aokblast/ThunderChargeXPro/RC_Charger_MainBoard/production/RC_Charger_MainBoard_2024-02-06_21-02-52/bom.csv

Designator | Footprint | Quantity | Value | LCSC Part #
C1, C2 | CP_EIA-3528-21_Kemet-B | 2 | 10u
C10, C7, C8, C9 | CP_Elec_6.3x7.7 | 4 | 68u
C11, C12, C13, C23, C270, C273, C3 | 0603 | 7 | 0.1u
C14, C26 | CP_Elec_10x10 | 2 | 560u
C27, C4, C44, C45, C46 | 1206 | 5 | 1u
C28, C29, C30, C31 | CP_Elec_6.3x5.4 | 4 | 22u
C47, C49, C51, C53 | 0805 | 4 | 0.47u
C48, C50, C52, C54 | 0805 | 4 | 0.68u
C5 | CP_Elec_4x5.7 | 1 | 10u
C6 | 0603 | 1 | 2.2n
D1 | D_SMA | 1 | CDBA360-HF
D2, D3 | D_SMA | 2 | SS54F
H1, H2, H3, H4 | MountingHole_4.3mm_M4_DIN965_Pad_TopBottom | 4 | M4
H5, H6 | MountingHole_8.4mm_M8_Pad_Via | 2 | M8
J1, J9 | PinHeader_2x03_P2.54mm_Vertical | 2 | Conn_02x03_Odd_Even
J3 | JST_XH_B2B-XH-A_1x02_P2.50mm_Vertical | 1 | SPK1
J4 | JST_XH_B2B-XH-A_1x02_P2.50mm_Vertical | 1 | SPK2
L1 | L_Taiyo-Yuden_NR-80xx_HandSoldering | 1 | 100u
L2, L3, L4, L5 | L_Taiyo-Yuden_NR-50xx_HandSoldering | 4 | 10u
L6, L7 | L_Bourns_SRR1260 | 2 | 15u
R1 | 0603 | 1 | 68k
R10, R17, R2 | 0603 | 3 | 10k
R11 | 0603 | 1 | 3.24k
R18 | 0603 | 1 | 5.9k
R4 | 0603 | 1 | 53.6k
R5 | 0603 | 1 | 12.1k
R6 | 0603 | 1 | 54.9k
R7 | 0603 | 1 | 2.43k
R8 | 0603 | 1 | 52.3k
R9 | 0603 | 1 | 73.2k
U1 | MODULE_NUCLEO-H745ZI-Q | 1 | NUCLEO-H745ZI-Q
U13 | VQFN-32-1EP_5x5mm_P0.5mm_EP3.1x3.1mm | 1 | TAS5825MRHB
U2 | 4-inch SPI screen | 1 | ~
U3 | TO-252-2 | 1 | L7805
U4 | SOIC-8_3.9x4.9mm_P1.27mm | 1 | LM5001MA
U5, U6 | Texas_R-PDSO-G8_EP2.95x4.9mm_Mask2.4x3.1mm_ThermalVias | 2 | TPS5430DDA
