aokblast/ThunderChargeXPro/FullBOM.xlsx

Sheet: ChargerPowerBoard
Designator | Value | Footprint | Quantity | quantity |  |  |  |  | 4619.67
C10,C33,C42,C55 | 100u | CP_Elec_6.3x7.7 |  | 4 | 14 | VZL101M1VTR-0607 (https://www.mouser.tw/ProductDetail/Lelon/VZL101M1VTR-0607) | 7.18 | 100.52
C11,C12,C13,C14,C30,C31,C32,C56,C57,C58,C59,C75,C76,C77 | 10u | 1206 |  | 14 | 49 | CL31A106MBHNNNE (https://www.mouser.tw/ProductDetail/Samsung-Electro-Mechanics/CL31A106MBHNNNE?qs=vLWxofP3U2ynwxdpGjlUyw%3D%3D) | 4.28 | 209.72
C17,C21,C23,C25,C27,C28,C62,C66,C68,C70,C72,C73 | 0.1u | 0603 |  | 12 | 42 | C0603C104M5RACAUTO (https://www.mouser.tw/ProductDetail/KEMET/C0603C104M5RACAUTO?qs=LnFVCKo%2FxLlaItaNxnozvw%3D%3D) | 1.27 | 53.34
C19,C64 | 560p | 0603 |  | 2 | 7 | CL10C561JB8NFNC (https://www.mouser.tw/ProductDetail/Samsung-Electro-Mechanics/CL10C561JB8NFNC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) | 0.923 | 6.461
C22,C67 | 68n | 0603 |  | 2 | 7 | CGA3E2X7R1H683M080AA (https://www.mouser.tw/ProductDetail/TDK/CGA3E2X7R1H683M080AA?qs=xLDY6iXSiQbQRXw5HcsOLg%3D%3D) | 1.71 | 11.97
C35,C36,C43,C44 | 22u | CP_Elec_6.3x5.4 |  | 4 | 14 | EEE-1VA220SP (https://www.mouser.tw/ProductDetail/Panasonic/EEE-1VA220SP) | 7.59 | 106.26
C38,C40,C92,C94 | 26p16V | 0603 |  | 4 | 14 | AC0603JRNPO9BN270 (https://www.mouser.tw/ProductDetail/YAGEO/AC0603JRNPO9BN270?qs=tS%2FAHvPQ%2F55GxSiGDraFxQ%3D%3D) | 1.4 | 19.6
D5 | SM4001 | D_MELF |  | 1 | 4 | SM4001 (https://www.mouser.tw/ProductDetail/Diotec-Semiconductor/SM4001?qs=OlC7AqGiEDlqPXaWDPfaLg%3D%3D) | 5.64 | 22.56
D6 | SM4001 | D_MELF |  | 1 | 4 | SM4001 (https://www.mouser.tw/ProductDetail/Diotec-Semiconductor/SM4001?qs=OlC7AqGiEDlqPXaWDPfaLg%3D%3D) |  | 0
K5,K6 | Relay_SPST-NO | T9GV5L145 |  | 2 | 7 | T9GV5L14-5 (https://www.mouser.tw/ProductDetail/TE-Connectivity-PB/T9GV5L14-5) | 108.42 | 758.94
L1,L6 | 4.7u | L_Bourns_SRP1770TA_16.9x16.9mm |  | 2 | 7 | SRP1770TA-4R7M (https://www.mouser.tw/ProductDetail/Bourns/SRP1770TA-4R7M?qs=P%2FbxraXw5h0TW8hufbRYNQ%3D%3D) | 94.06 | 658.42
Q10,Q11,Q12,Q13,Q14,Q7,Q8,Q9 | IRFH5210 | PQFN-8-EP_6x5mm_P1.27mm_Generic |  | 8 | 28 | IRFH7545TRPBF (https://www.mouser.tw/ProductDetail/Infineon-Technologies/IRFH7545TRPBF?qs=NBFAU1oqP4Xy0KalJOxHdQ%3D%3D) | 21.34 | 597.52
Q21,Q22 | AO3400A | SOT-23 |  | 2 | 7 | IRLML6344TRPBF (https://www.mouser.tw/ProductDetail/Infineon-Technologies/IRLML6344TRPBF?qs=9%252BKlkBgLFf2w4qS48UOXVw%3D%3D) | 12.76 | 89.32
R1,R2,R3,R4,R5,R6,R77,R78,R79,R80,R81,R82 | 50 | 2512 |  | 12 | 42 | CRCW251249R9FKEGHP (https://www.mouser.tw/ProductDetail/Vishay-Dale/CRCW251249R9FKEGHP?qs=k2%2FDWSARqgFnooSUq8QfKQ%3D%3D) | 14.78 | 620.76
R107,R108,R109,R110,R111,R112,R113,R114,R115,R116,R117,R118,R31,R32,R33,R34,R35,R36,R37,R38,R39,R40,R41,R42 | 7.87k | 0603 |  | 24 | 84 | CRCW06037K87FKEA (https://www.mouser.tw/ProductDetail/Vishay-Dale/CRCW06037K87FKEA?qs=IojMgTCMkEdTY99SGkX1pA%3D%3D) | 0.342 | 28.728
R119,R120,R58,R59 | 68 | 0603 |  | 4 | 14 | CRCW060368R0FKEAHP (https://www.mouser.tw/ProductDetail/Vishay-Dale/CRCW060368R0FKEAHP?qs=YmE2lSBYOPlEK%2FcM9tkokA%3D%3D) | 1.74 | 24.36
R245,R246 | 1.5M | 0603 |  | 2 | 7 | CRCW06031M50FKEA (https://www.mouser.tw/ProductDetail/Vishay-Dale/CRCW06031M50FKEA?qs=ZrSeLeYd2mLBVxYQ1%252B0cuQ%3D%3D) | 0.581 | 4.067
R249,R252 | 9.53k | 0603 |  | 2 | 7 | CRCW06039K53FKEA (https://www.mouser.tw/ProductDetail/Vishay-Dale/CRCW06039K53FKEA?qs=NvrC5vRk3q5mn1EuZvzW6A%3D%3D) | 0.581 | 4.067
R47,R66 | 42.2k | 0603 |  | 2 | 7 | CRCW060342K2FKEA (https://www.mouser.tw/ProductDetail/Vishay-Dale/CRCW060342K2FKEA?qs=v0cjL%2FPx3nyx0V5tfB02DQ%3D%3D) | 0.65 | 4.55
R50,R69 | 2.61k | 0603 |  | 2 | 7 | CRCW06032K61FKEA (https://www.mouser.tw/ProductDetail/Vishay-Dale/CRCW06032K61FKEA?qs=rWmqDOB7Xyh0TeaTOrunVg%3D%3D) | 0.581 | 4.067
R53,R72 | 3m | 2818 |  | 2 | 7 | WSHM28183L000FEB (https://www.mouser.tw/ProductDetail/Vishay-Dale/WSHM28183L000FEB?qs=OiptqVrkjbpQDIrtklFs6Q%3D%3D) | 43.1 | 301.7
R55,R74 | 3m | R_Shunt_Vishay_WSK2512_6332Metric_T2.21mm |  | 2 | 7 | MSMA2512R0030FEN (https://www.mouser.tw/ProductDetail/Bussmann-Eaton/MSMA2512R0030FEN?qs=By6Nw2ByBD06wTr8XIiA3Q%3D%3D) | 9 | 63
R57,R76 | 4m | R_Shunt_Vishay_WSK2512_6332Metric_T2.21mm |  | 2 | 7 | MSMA2512R0040FEN (https://www.mouser.tw/ProductDetail/Bussmann-Eaton/MSMA2512R0040FEN?qs=By6Nw2ByBD3A3gmSEIRZGQ%3D%3D) | 9 | 63
U10,U16 | MP2984 | QFN-32-1EP_4x4mm_P0.4mm_EP2.65x2.65mm |  | 2 | 7 |  |  | 0
U11,U17 | INA180A1 | SOT-23-5 |  | 2 | 7 | INA180A1IDBVR (https://www.mouser.tw/ProductDetail/Texas-Instruments/INA180A1IDBVR?qs=5aG0NVq1C4wnkaOukGk95A%3D%3D) | 10.88 | 76.16
U59,U62 | INA240A1D | SOIC-8_3.9x4.9mm_P1.27mm |  | 2 | 7 | INA240A1DR (https://www.mouser.tw/ProductDetail/Texas-Instruments/INA240A1DR?qs=AQlKX63v8Rv7XB07RTzuHA%3D%3D) | 94.06 | 658.42
Y1,Y2 | 8M | Crystal_SMD_Abracon_ABM3B-4Pin_5.0x3.2mm |  | 2 | 7 | ABM3B-8.000MHZ-B2-T (https://www.mouser.tw/ProductDetail/ABRACON/ABM3B-8.000MHZ-B2-T?qs=NE97hfUNX0Ef9OqIOqO2cA%3D%3D) | 18.88 | 132.16

Sheet: ChargerMainBoard
Designator | Value | Footprint | Quantity | quantity |  |  |  |  | 1544.2
R7 | 2.43k | 0603 |  | 1 | 10 | CRCW06032K43FKEA (https://www.mouser.tw/ProductDetail/Vishay-Dale/CRCW06032K43FKEA?qs=eDxIiLd4fLRD3G8bVTELcA%3D%3D) | 0.65 | 6.5
R18 | 5.9k | 0603 |  | 1 | 10 | CRCW06035K90FKEA (https://www.mouser.tw/ProductDetail/Vishay-Dale/CRCW06035K90FKEA?qs=2kV0shNyW71rKkh24eBQEg%3D%3D) | 0.581 | 5.81
R5 | 12.1k | 0603 |  | 1 | 10 | CRCW060312K1FKEA (https://www.mouser.tw/ProductDetail/Vishay-Dale/CRCW060312K1FKEA?qs=BcvNGmdp0KVGHQVkR%252BFsVA%3D%3D) | 0.65 | 6.5
R8 | 52.3k | 0603 |  | 1 | 10 | CRCW060352K3FKEA (https://www.mouser.tw/ProductDetail/Vishay-Dale/CRCW060352K3FKEA?qs=SnLvHVux46osufKy5hEuZA%3D%3D) | 0.581 | 5.81
R9 | 73.2k | 0603 |  | 1 | 10 | CRCW060373K2FKEA (https://www.mouser.tw/ProductDetail/Vishay-Dale/CRCW060373K2FKEA?qs=wtKLRx7HFiWbNo88VwpoiQ%3D%3D) | 0.65 | 6.5
R11 | 3.24k | 0603 |  | 1 | 10 | CRCW06033K24FKEAC (https://www.mouser.tw/ProductDetail/Vishay-Dale/CRCW06033K24FKEAC?qs=E3Y5ESvWgWMGhBnGc19ywA%3D%3D) | 0.616 | 6.16
C5 | 10u | CAP-SMD_BD5.0-L5.3-W5.3-LS6.3-FD |  | 1 | 3 | EDH106M050A9DAA (https://www.mouser.tw/ProductDetail/KEMET/EDH106M050A9DAA) | 7.18 | 21.54
U4 | LM5001MA | SOIC-8_3.9x4.9mm_P1.27mm |  | 1 | 3 | LM5001MAX/NOPB (https://www.mouser.tw/ProductDetail/Texas-Instruments/LM5001MAX-NOPB?qs=QbsRYf82W3FL7Egz0HJkAQ%3D%3D) | 150.49 | 451.47
C48,C50,C52,C54 | 0.68u | 0805 |  | 4 | 10 | C0805C684K5REC7210 (https://www.mouser.tw/ProductDetail/KEMET/C0805C684K5REC7210) | 5.68 | 56.8
U13 | TAS5825MRHB | VQFN-32-1EP_5x5mm_P0.5mm_EP3.1x3.1mm |  | 1 | 3 | TAS5825MRHBR (https://www.mouser.tw/ProductDetail/Texas-Instruments/TAS5825MRHBR?qs=f9yNj16SXrKGX4MqJgnnYg%3D%3D) | 124.5 | 373.5
R4 | 53.6k | 0603 |  | 1 | 10 | CRCW060353K6FKEA (https://www.mouser.tw/ProductDetail/Vishay-Dale/CRCW060353K6FKEA?qs=t%2Fk8jExiEqtUVENO6f39Cw%3D%3D) | 0.581 | 5.81
R6 | 54.9k | 0603 |  | 1 | 10 | CRCW060354K9FKEA (https://www.mouser.tw/ProductDetail/Vishay-Dale/CRCW060354K9FKEA?qs=b7E%2F5v%252Bp8lqNIpTCMX%252BLUg%3D%3D) | 0.581 | 5.81
L6,L7 | 15u | L_Bourns_SRR1260 |  | 2 | 5 | SRR1260-150M (https://www.mouser.tw/ProductDetail/Bourns/SRR1260-150M?qs=y9m3SKnhpLPF5BoYDkDwgQ%3D%3D) | 25.31 | 126.55
L1 | 100u | L_Taiyo-Yuden_NR-80xx_HandSoldering |  | 1 | 3 | NR8040T101M (https://www.mouser.tw/ProductDetail/TAIYO-YUDEN/NR8040T101M?qs=PzICbMaShUf5KnjQbcM1ow%3D%3D) | 15.73 | 47.19
C10,C7,C8,C9 | 68u | CP_Elec_6.3x7.7 |  | 4 | 10 | EEV686M035A9HAA (https://www.mouser.tw/ProductDetail/KEMET/EEV686M035A9HAA) | 10.23 | 102.3
L2,L3,L4,L5 | 10u | L_Taiyo-Yuden_NR-50xx_HandSoldering |  | 4 | 10 | NR5040T100M (https://www.mouser.tw/ProductDetail/TAIYO-YUDEN/NR5040T100M?qs=PzICbMaShUcSxn8FHypdZA%3D%3D) | 7.76 | 77.6
C28,C29,C30,C31 | 22u | CP_Elec_6.3x5.4 |  | 4 | 10 | EEE-1VA220SP (https://www.mouser.tw/ProductDetail/Panasonic/EEE-1VA220SP) | 7.59 | 75.9
C14,C26 | 560u | CP_Elec_10x10 |  | 2 | 5 | EEE-FN1V561UP (https://www.mouser.tw/ProductDetail/Panasonic/EEE-FN1V561UP) | 32.49 | 162.45

Sheet: Order
 |  |  |  |  |  | 21261.671 |  |  |  |  | 9297.477
C0603C104J5RAC7411 (https://www.mouser.tw/ProductDetail/KEMET/C0603C104J5RAC7411?qs=sGAEpiMZZMvsSlwiRhF8qnxGm16OHeZjwoFLW7GiWz0%3D) | 127 | C2220C226M5R2CT500 (https://www.mouser.tw/ProductDetail/KEMET/C2220C226M5R2CT500?qs=cRF2oMUWtTcXdS78BxhVuQ%3D%3D) | 30 | 140.57 | 4217.1 |  | LM5001MAX-NOPB | 3 | 150.49 | 451.47
AEK1010101M050R (https://www.mouser.tw/ProductDetail/KYOCERA-AVX/AEK1010101M050R?qs=MyNHzdoqoQIQJGuoaqHnWA%3D%3D) | 19 | STM32F103CBT6TR | 10 | 178.54 | 1785.4 |  | SRP1770TA-4R7M | 6 | 142.97 | 857.82
C1210C106K6PACTU (https://www.mouser.tw/ProductDetail/KEMET/C1210C106K6PACTU?qs=sGAEpiMZZMvsSlwiRhF8qnaoi2Fm8R546YxnrmKumDM%3D) | 64 | IRFH5210TRPBF | 37 | 41.73 | 1544.01 |  | TAS5825MRHBR | 3 | 124.5 | 373.5
C0805X225K5RACAUTO (https://www.mouser.tw/ProductDetail/KEMET/C0805X225K5RACAUTO?qs=HBWAp0VN4Ri3sxmR2yBS2w%3D%3D) | 19 | WSLP27264L000FEA | 19 | 61.57 | 1169.83 |  | T9GV5L14-5 | 6 | 114.92 | 689.52
C0603C104J5RAC7411 (https://www.mouser.tw/ProductDetail/KEMET/C0603C104J5RAC7411?qs=sGAEpiMZZMvsSlwiRhF8qnxGm16OHeZjwoFLW7GiWz0%3D) | 55 | TPS54560BDDA | 6 | 184.01 | 1104.06 |  | INA240A1DR | 6 | 110.48 | 662.88
C0603C101K5RACAUTO (https://www.mouser.tw/ProductDetail/KEMET/C0603C101K5RACAUTO?qs=7LShN427%2FM7V249iWz%2FEhQ%3D%3D) | 10 | T9GV5L14-5 | 10 | 108.42 | 1084.2 |  | WSLP27263L000FEA | 6 | 79.35 | 476.1
C0603C561J1RACTU (https://www.mouser.tw/ProductDetail/KEMET/C0603C561J1RACTU?qs=8my90YoEduff8TFYul8jtA%3D%3D) | 10 | C1210C106K5RACTU (https://www.mouser.tw/ProductDetail/KEMET/C1210C106K5RACTU?qs=Ay79KZaUeZCnuZLm9qvTNQ%3D%3D) | 64 | 15.97 | 1022.08 |  | WSLP27264L000FEA | 11 | 61.57 | 677.27
C0603C473K5RACAUTO (https://www.mouser.tw/ProductDetail/KEMET/C0603C473K5RACAUTO?qs=YnWkDRoGECgDcRktBi4yDw%3D%3D) | 10 | INA240A1DR | 10 | 94.06 | 940.6 |  | SRP1038C-8R2M | 4 | 44.12 | 176.48
C0603C683K5RACAUTO7411 (https://www.mouser.tw/ProductDetail/KEMET/C0603C683K5RACAUTO7411?qs=sSYV1F9c5cGf7kgcDWZsOA%3D%3D) | 10 | SRP1770TA-4R7M | 10 | 94.06 | 940.6 |  | IRFH5210TRPBF | 21 | 41.73 | 876.33
C0603C470K5GAC (https://www.mouser.tw/ProductDetail/KEMET/C0603C470K5GAC?qs=Zjfhvh7dXTMIOQf3nK1HJg%3D%3D) | 10 | CRCW251249R9FKEGHP | 55 | 14.78 | 812.9 |  | SRP7030-100M (https://www.mouser.tw/ProductDetail/Bourns/SRP7030-100M?qs=P41GyhEsKL4Qq8MjPmWJvA%3D%3D) | 7 | 26.34 | 184.38
C0603C224K5RACAUTO (https://www.mouser.tw/ProductDetail/KEMET/C0603C224K5RACAUTO?qs=HoCaDK9Nz5cZKUqpgQ%252BnIA%3D%3D) | 28 | WSLP27263L000FEA | 10 | 64.3 | 643 |  | L78M05CDT-TR | 7 | 24.28 | 169.96
C2220C226M5R2C7186 (https://www.mouser.tw/ProductDetail/KEMET/C2220C226M5R2C7186?qs=QXapti0WIWK5mbAQgwqGAg%3D%3D) | 19 | LM5001MAX-NOPB | 4 | 150.49 | 601.96 |  | ABM3B-8.000MHZ-B2-T | 6 | 20.86 | 125.16
C0603C270J5GACAUTO (https://www.mouser.tw/ProductDetail/KEMET/C0603C270J5GACAUTO?qs=LnFVCKo%2FxLn0D8SQzKEMpQ%3D%3D) | 19 | C0805C225K5RACAUTO (https://www.mouser.tw/ProductDetail/KEMET/C0805C225K5RACAUTO?qs=HBWAp0VN4RhaI2JFGdfu4w%3D%3D) | 40 | 13.27 | 530.8 |  | AEK1010100M160R | 3 | 20.86 | 62.58
TCJB106M035R0200 (https://www.mouser.tw/ProductDetail/KYOCERA-AVX/TCJB106M035R0200) | 10 | TAS5825MRHBR | 4 | 124.5 | 498 |  | AEK1010101M050R | 11 | 19.84 | 218.24
150060SS75000 | 19 | LTV-817S | 55 | 8.14 | 447.7 |  | TCJB106M035R0200 | 10 | 19.15 | 191.5
SM4001 (https://www.mouser.tw/ProductDetail/Diotec-Semiconductor/SM4001?qs=OlC7AqGiEDlqPXaWDPfaLg%3D%3D) | 10 | DMG2301L-7 | 55 | 7.42 | 408.1 |  | C1210C106K5RACTU (https://www.mouser.tw/ProductDetail/KEMET/C1210C106K5RACTU?qs=Ay79KZaUeZCnuZLm9qvTNQ%3D%3D) | 36 | 15.97 | 574.92
T9GV5L14-5 (https://www.mouser.tw/ProductDetail/TE-Connectivity-PB/T9GV5L14-5) | 10 | AEK1010101M050R | 19 | 19.84 | 376.96 |  | IRLML6344TRPBF | 6 | 15.39 | 92.34
SRP1770TA-4R7M (https://www.mouser.tw/ProductDetail/Bourns/SRP1770TA-4R7M?qs=P%2FbxraXw5h0TW8hufbRYNQ%3D%3D) | 10 | TCJB106M035R0200 | 16 | 19.15 | 306.4 |  | CRCW251249R9FKEGHP | 31 | 14.78 | 458.18
DMG2301L-13 (https://www.mouser.tw/ProductDetail/Diodes-Incorporated/DMG2301L-13) | 55 | LM2904QS-13 | 28 | 9.92 | 277.76 |  | SRU1028-101Y | 3 | 14.02 | 42.06
IRFH5210TRPBF (https://www.mouser.tw/ProductDetail/Infineon-Technologies/IRFH5210TRPBF?qs=Z8%252BeY1k3TIIF13We7Il9og%3D%3D) | 37 | SRP1038C-8R2M | 6 | 44.12 | 264.72 |  | INA180A1IDBVR | 6 | 13.68 | 82.08
IRLML6344TRPBF (https://www.mouser.tw/ProductDetail/Infineon-Technologies/IRLML6344TRPBF?qs=9%252BKlkBgLFf2w4qS48UOXVw%3D%3D) | 10 | SRP7030-100M (https://www.mouser.tw/ProductDetail/Bourns/SRP7030-100M?qs=P41GyhEsKL4Qq8MjPmWJvA%3D%3D) | 11 | 22.68 | 249.48 |  | C0805C225K5RACAUTO (https://www.mouser.tw/ProductDetail/KEMET/C0805C225K5RACAUTO?qs=HBWAp0VN4RhaI2JFGdfu4w%3D%3D) | 24 | 13.27 | 318.48
CRCW251249R9FKEGHP (https://www.mouser.tw/ProductDetail/Vishay-Dale/CRCW251249R9FKEGHP?qs=k2%2FDWSARqgFnooSUq8QfKQ%3D%3D) | 55 | L78M05CDT-TR | 10 | 20.15 | 201.5 |  | CDBA360-HF | 3 | 12.31 | 36.93
CRCW06031K00FKEC (https://www.mouser.tw/ProductDetail/Vishay-Dale/CRCW06031K00FKEC?qs=LTJBsG9vER03gQprIr9%2F9w%3D%3D) | 109 | ABM3B-8.000MHZ-B2-T | 10 | 18.88 | 188.8 |  | B560C | 4 | 11.97 | 47.88
CRCW060310K0FKEAC (https://www.mouser.tw/ProductDetail/Vishay-Dale/CRCW060310K0FKEAC?qs=E3Y5ESvWgWPkZNxkE0GwZg%3D%3D) | 154 | EEE-FT1V470AR | 16 | 9.88 | 158.08 |  | LM2904QS-13 | 16 | 9.92 | 158.72
CRCW06037K87FKEA (https://www.mouser.tw/ProductDetail/Vishay-Dale/CRCW06037K87FKEA?qs=IojMgTCMkEdTY99SGkX1pA%3D%3D) | 109 | C0603C224K5RACAUTO | 28 | 5.47 | 153.16 |  | EEE-FT1V470AR | 10 | 9.88 | 98.8
CRCW060368R0FKEAHP (https://www.mouser.tw/ProductDetail/Vishay-Dale/CRCW060368R0FKEAHP?qs=YmE2lSBYOPlEK%2FcM9tkokA%3D%3D) | 19 | IRLML6344TRPBF | 10 | 12.76 | 127.6 |  | LTV-817S | 31 | 8.14 | 252.34
CRCW060368K0FKEAC (https://www.mouser.tw/ProductDetail/Vishay-Dale/CRCW060368K0FKEAC?qs=E3Y5ESvWgWOWm3dIamBggg%3D%3D) | 10 | INA180A1IDBVR | 10 | 10.88 | 108.8 |  | SM4001 | 6 | 7.87 | 47.22
CRCW06031M50FKEA (https://www.mouser.tw/ProductDetail/Vishay-Dale/CRCW06031M50FKEA?qs=ZrSeLeYd2mLBVxYQ1%252B0cuQ%3D%3D) | 10 | 150060SS75000 | 19 | 5.13 | 97.47 |  | DMG2301L-13 | 31 | 7.42 | 230.02
CRCW06039K53FKEA (https://www.mouser.tw/ProductDetail/Vishay-Dale/CRCW06039K53FKEA?qs=NvrC5vRk3q5mn1EuZvzW6A%3D%3D) | 10 | AEK1010100M160R | 4 | 20.86 | 83.44 |  | C0603C224K5RACAUTO (https://www.mouser.tw/ProductDetail/KEMET/C0603C224K5RACAUTO?qs=HoCaDK9Nz5cZKUqpgQ%252BnIA%3D%3D) | 16 | 5.47 | 87.52
CRCW06032K20FKEA (https://www.mouser.tw/ProductDetail/Vishay-Dale/CRCW06032K20FKEA?qs=wckIcdUuIXiMEbhHncbunA%3D%3D) | 19 | B560C | 6 | 11.97 | 71.82 |  | 150060SS75000 | 11 | 5.13 | 56.43
CRCW0603100KFKEC (https://www.mouser.tw/ProductDetail/Vishay-Dale/CRCW0603100KFKEC?qs=DhCTQV%252BB7kWoDWqqRJpYTw%3D%3D) | 19 | C0603C104M5RACTU (https://www.mouser.tw/ProductDetail/KEMET/C0603C104M5RACTU?qs=YkRtRX%252BfoqJT%252B0m410IP4A%3D%3D) | 197 | 0.342 | 67.374 |  | C0805C684M5RECTU (https://www.mouser.tw/ProductDetail/KEMET/C0805C684M5RECTU?qs=55YtniHzbhCdhrRzpDGBZw%3D%3D) | 10 | 4.34 | 43.4
CRCW060342K2FKEA (https://www.mouser.tw/ProductDetail/Vishay-Dale/CRCW060342K2FKEA?qs=v0cjL%2FPx3nyx0V5tfB02DQ%3D%3D) | 10 | CRCW060310K0FKEAC | 158 | 0.41 | 64.78 |  | C0805C474K5RACTU (https://www.mouser.tw/ProductDetail/KEMET/C0805C474K5RACTU?qs=nLJruSqDb94g3rYuYFW2HQ%3D%3D) | 10 | 3.97 | 39.7
CRCW06033K30FKEBC (https://www.mouser.tw/ProductDetail/Vishay-Dale/CRCW06033K30FKEBC?qs=wd5RIQLrsJj7m9%252BtPczvuw%3D%3D) | 10 | C1206C105K5RACTU (https://www.mouser.tw/ProductDetail/KEMET/C1206C105K5RACTU?qs=STjISULpmtb6FskosHpJdg%3D%3D) | 15 | 3.9 | 58.5 |  | C1206C105K5RACTU (https://www.mouser.tw/ProductDetail/KEMET/C1206C105K5RACTU?qs=STjISULpmtb6FskosHpJdg%3D%3D) | 10 | 3.9 | 39
CRCW06032K61FKEA (https://www.mouser.tw/ProductDetail/Vishay-Dale/CRCW06032K61FKEA?qs=rWmqDOB7Xyh0TeaTOrunVg%3D%3D) | 10 | SM4001 | 10 | 5.64 | 56.4 |  | C0603C123K5RACTU (https://www.mouser.tw/ProductDetail/KEMET/C0603C123K5RACTU?qs=sa3El95%252BHy7r9lXf4LoZRQ%3D%3D) | 4 | 3.42 | 13.68
CRCW0603100RFKEA (https://www.mouser.tw/ProductDetail/Vishay-Dale/CRCW0603100RFKEA?qs=90AHS1y%2FsidGWjjxZAupKg%3D%3D) | 37 | SRU1028-101Y | 4 | 14.02 | 56.08 |  | C0603C100J1GACAUTO | 3 | 3.42 | 10.26
WSLP27264L000FEA (https://www.mouser.tw/ProductDetail/Vishay-Dale/WSLP27264L000FEA?qs=P0I6NS6hZyTwVyHUmSy6hg%3D%3D) | 19 | CDBA360-HF | 4 | 12.31 | 49.24 |  | C0603C561J5GAC (https://www.mouser.tw/ProductDetail/KEMET/C0603C561J5GAC?qs=Zjfhvh7dXTMKgX2HGsAFfw%3D%3D) | 10 | 2.09 | 20.9
WSLP27263L000FEA (https://www.mouser.tw/ProductDetail/Vishay-Dale/WSLP27263L000FEA?qs=P0I6NS6hZyTg1KXVWrHq2Q%3D%3D) | 10 | C0805C684M5RECTU (https://www.mouser.tw/ProductDetail/KEMET/C0805C684M5RECTU?qs=55YtniHzbhCdhrRzpDGBZw%3D%3D) | 11 | 4.34 | 47.74 |  | C0603C683K5RACAUTO7411 | 10 | 2.05 | 20.5
LTV-817S (https://www.mouser.tw/ProductDetail/Lite-On/LTV-817S?qs=XpF7qU%252BvLkWYeWEC0OckNQ%3D%3D) | 55 | C0805C474K5RACTU (https://www.mouser.tw/ProductDetail/KEMET/C0805C474K5RACTU?qs=nLJruSqDb94g3rYuYFW2HQ%3D%3D) | 11 | 3.97 | 43.67 |  | CRCW060368R0FKEAHP | 11 | 1.74 | 19.14
INA180A1IDBVR (https://www.mouser.tw/ProductDetail/Texas-Instruments/INA180A1IDBVR?qs=5aG0NVq1C4wnkaOukGk95A%3D%3D) | 10 | CRCW06037K87FKEA | 109 | 0.342 | 37.278 |  | C0603C470K5GAC (https://www.mouser.tw/ProductDetail/KEMET/C0603C470K5GAC?qs=Zjfhvh7dXTMIOQf3nK1HJg%3D%3D) | 10 | 1.61 | 16.1
L78M05CDT-TR (https://www.mouser.tw/ProductDetail/STMicroelectronics/L78M05CDT-TR?qs=JIXmGdi%252BcuKa7ml6d%2FqNIw%3D%3D) | 6 | CRCW060368R0FKEAHP | 19 | 1.74 | 33.06 |  | C0603C101J1HAUTO | 10 | 1.5 | 15
STM32F103CBT6TR (https://www.mouser.tw/ProductDetail/STMicroelectronics/STM32F103CBT6TR?qs=SU4Xa%252BYHGQr0GBvhN6Y2ig%3D%3D) | 10 | CRCW06031K00FKECC | 109 | 0.274 | 29.866 |  | C0603C473K5RACTU (https://www.mouser.tw/ProductDetail/KEMET/C0603C473K5RACTU?qs=CDC5R06TEgYvy7Nwr10FTA%3D%3D) | 10 | 1.13 | 11.3
LM2904QS-13 (https://www.mouser.tw/ProductDetail/Diodes-Incorporated/LM2904QS-13?qs=g6T3zOPhKMBXFje19A9eFA%3D%3D) | 28 | C0603C470K5GAC (https://www.mouser.tw/ProductDetail/KEMET/C0603C470K5GAC?qs=Zjfhvh7dXTMIOQf3nK1HJg%3D%3D) | 14 | 1.61 | 22.54 |  | C0603C472J5RACTU (https://www.mouser.tw/ProductDetail/KEMET/C0603C472J5RACTU?qs=%252B1IPXjmgXQInZEuVb89aSA%3D%3D) | 10 | 0.752 | 7.52
INA240A1DR (https://www.mouser.tw/ProductDetail/Texas-Instruments/INA240A1DR?qs=AQlKX63v8Rv7XB07RTzuHA%3D%3D) | 10 | C0603C561J5GAC (https://www.mouser.tw/ProductDetail/KEMET/C0603C561J5GAC?qs=Zjfhvh7dXTMKgX2HGsAFfw%3D%3D) | 10 | 2.09 | 20.9 |  | C0603C270J5GACTU (https://www.mouser.tw/ProductDetail/KEMET/C0603C270J5GACTU?qs=tmo4rc6ZD9Wc1Km2xObD4A%3D%3D) | 11 | 0.718 | 7.898
ABM3B-8.000MHZ-B2-T (https://www.mouser.tw/ProductDetail/ABRACON/ABM3B-8.000MHZ-B2-T?qs=NE97hfUNX0Ef9OqIOqO2cA%3D%3D) | 10 | C0603C683K5RACAUTO7411 | 10 | 2.05 | 20.5 |  | CRCW0603243KFKEA | 10 | 0.65 | 6.5
TCJB106M035R0200 (https://www.mouser.tw/ProductDetail/KYOCERA-AVX/TCJB106M035R0200) | 6 | CRCW0603100RFKEA | 37 | 0.547 | 20.239 |  | CRCW06032K43FKEA | 10 | 0.65 | 6.5
C0805X225K5RACAUTO (https://www.mouser.tw/ProductDetail/KEMET/C0805X225K5RACAUTO?qs=HBWAp0VN4Ri3sxmR2yBS2w%3D%3D) | 21 | C0603C101J1HAUTO | 10 | 1.5 | 15 |  | CRCW060342K2FKEA | 10 | 0.65 | 6.5
C0603C104J5RAC7411 (https://www.mouser.tw/ProductDetail/KEMET/C0603C104J5RAC7411?qs=sGAEpiMZZMvsSlwiRhF8qnxGm16OHeZjwoFLW7GiWz0%3D) | 9 | C0603C123K5RACTU (https://www.mouser.tw/ProductDetail/KEMET/C0603C123K5RACTU?qs=sa3El95%252BHy7r9lXf4LoZRQ%3D%3D) | 4 | 3.42 | 13.68 |  | CRCW060373K2FKEA | 10 | 0.65 | 6.5
EEE-FT1V470AR (https://www.mouser.tw/ProductDetail/Panasonic/EEE-FT1V470AR?qs=CMJjuEs1%252BuFjjWI0fhmJAA%3D%3D) | 16 | C0603C270J5GACTU (https://www.mouser.tw/ProductDetail/KEMET/C0603C270J5GACTU?qs=tmo4rc6ZD9Wc1Km2xObD4A%3D%3D) | 19 | 0.718 | 13.642 |  | C0603C222K5RACTU (https://www.mouser.tw/ProductDetail/KEMET/C0603C222K5RACTU?qs=YImQdUCIZz7OXZy7YD441g%3D%3D) | 10 | 0.616 | 6.16
C0603X472K5RACAUTO (https://www.mouser.tw/ProductDetail/KEMET/C0603X472K5RACAUTO?qs=i1BTgFBVgONXYhQkv0AXWw%3D%3D) | 4 | C0603C100J1GACAUTO | 10 | 1.23 | 12.3 |  | CRCW060310K2FKEAC | 10 | 0.616 | 6.16
C0603H470J5GACTU (https://www.mouser.tw/ProductDetail/KEMET/C0603X472K5RACAUTO?qs=i1BTgFBVgONXYhQkv0AXWw%3D%3D) | 4 | C0603C473K5RACTU (https://www.mouser.tw/ProductDetail/KEMET/C0603C473K5RACTU?qs=CDC5R06TEgYvy7Nwr10FTA%3D%3D) | 10 | 1.13 | 11.3 |  | CRCW060312K1FKEAC | 10 | 0.616 | 6.16
C0603C123J1RACAUTO (https://www.mouser.tw/ProductDetail/KEMET/C0603C123J1RACAUTO?qs=KUoIvG%2F9Ilb485RDquKbsQ%3D%3D) | 4 | CRCW0603100KFKEC | 19 | 0.581 | 11.039 |  | CRCW0603100KFKEC | 11 | 0.581 | 6.391
C0603C100F2TACAUTO (https://www.mouser.tw/ProductDetail/KEMET/C0603C100F2TACAUTO?qs=Znm5pLBrcAJMiROlQhngZA%3D%3D) | 4 | CRCW06032K20FKEA | 19 | 0.581 | 11.039 |  | CRCW06032K20FKEA | 11 | 0.581 | 6.391
C1206X105K5RACAUTO (https://www.mouser.tw/ProductDetail/KEMET/C1206X105K5RACAUTO?qs=6HsNZxDn%2FfKwT%252B7ge6cI%252Bg%3D%3D) | 11 | CRCW060368K0JNEA (https://www.mouser.tw/ProductDetail/Vishay-Dale/CRCW060368K0JNEA?qs=DAOw7tDt2pH5T4tTEGEEeA%3D%3D) | 14 | 0.581 | 8.134 |  | CRCW060311K8FKEA | 10 | 0.581 | 5.81
C0603C104J5RAC7411 (https://www.mouser.tw/ProductDetail/KEMET/C0603C104J5RAC7411?qs=sGAEpiMZZMvsSlwiRhF8qnxGm16OHeZjwoFLW7GiWz0%3D) | 6 | C0603C472J5RACTU (https://www.mouser.tw/ProductDetail/KEMET/C0603C472J5RACTU?qs=%252B1IPXjmgXQInZEuVb89aSA%3D%3D) | 10 | 0.752 | 7.52 |  | CRCW060316K9FKEA | 10 | 0.581 | 5.81
C2220C226M5R2C7186 (https://www.mouser.tw/ProductDetail/KEMET/C2220C226M5R2C7186?qs=QXapti0WIWK5mbAQgwqGAg%3D%3D) | 11 | CRCW0603243KFKEA | 10 | 0.65 | 6.5 |  | CRCW06031M50FKEA | 10 | 0.581 | 5.81
C1206X105K5RACAUTO (https://www.mouser.tw/ProductDetail/KEMET/C1206X105K5RACAUTO?qs=6HsNZxDn%2FfKwT%252B7ge6cI%252Bg%3D%3D) | 4 | CRCW06032K43FKEA | 10 | 0.65 | 6.5 |  | CRCW06032K61FKEA | 10 | 0.581 | 5.81
C0805X474K5RACAUTO (https://www.mouser.tw/ProductDetail/KEMET/C0805X474K5RACAUTO?qs=YupXwlO67giGPW66QH%2FFPQ%3D%3D) | 11 | CRCW060342K2FKEA (https://www.mouser.tw/ProductDetail/Vishay-Dale/CRCW060342K2FKEA?qs=v0cjL%2FPx3nyx0V5tfB02DQ%3D%3D) | 10 | 0.65 | 6.5 |  | CRCW06033K30FKEBC | 10 | 0.581 | 5.81
C0805X684K5RACAUTO (https://www.mouser.tw/ProductDetail/KEMET/C0805X684K5RACAUTO?qs=YupXwlO67ggRcTy%2F7L1QGQ%3D%3D) | 11 | CRCW060373K2FKEA | 10 | 0.65 | 6.5 |  | CRCW0603442KFKEA | 10 | 0.581 | 5.81
AEK1010100M160R (https://www.mouser.tw/ProductDetail/KYOCERA-AVX/AEK1010100M160R?qs=MyNHzdoqoQJgU5WdEgjlmg%3D%3D) | 4 | C0603C222K5RACTU (https://www.mouser.tw/ProductDetail/KEMET/C0603C222K5RACTU?qs=YImQdUCIZz7OXZy7YD441g%3D%3D) | 10 | 0.616 | 6.16 |  | CRCW060352K3FKEA | 10 | 0.581 | 5.81
C0603X222K5RACAUTO (https://www.mouser.tw/ProductDetail/KEMET/C0603X222K5RACAUTO?qs=i1BTgFBVgOP6zD2W%2F7ipmw%3D%3D) | 4 | CRCW060310K2FKEAC | 10 | 0.616 | 6.16 |  | CRCW060353K6FKEAC | 10 | 0.581 | 5.81
CDBA360-HF (https://www.mouser.tw/ProductDetail/Comchip-Technology/CDBA360-HF?qs=h4btpMc8RH%252BNuUBa0R2P7g%3D%3D) | 4 | CRCW060312K1FKEAC | 10 | 0.616 | 6.16 |  | CRCW060354K9FKEA | 10 | 0.581 | 5.81
B560C (https://www.mouser.tw/ProductDetail/Diodes-Incorporated/B560C?qs=e5T%2FzGlhGObuwwV6I9BY7Q%3D%3D) | 6 | CRCW060311K8FKEA | 10 | 0.581 | 5.81 |  | CRCW060368K0FKEAC | 10 | 0.581 | 5.81
SRU1028-101Y (https://www.mouser.tw/ProductDetail/Bourns/SRU1028-101Y?qs=kXUsL7gzrIURb8fFk5hYYg%3D%3D) | 4 | CRCW060316K9FKEA | 10 | 0.581 | 5.81 |  | CRCW06039K53FKEA | 10 | 0.581 | 5.81
SRP7028A-100M (https://www.mouser.tw/ProductDetail/Bourns/SRP7028A-100M?qs=7z%252BmIopC6%2FIen3yqnoi56A%3D%3D) | 11 | CRCW06031M50FKEA | 10 | 0.581 | 5.81 |  | CRCW0603100RFKEA | 21 | 0.547 | 11.487
SRP1038C-8R2M (https://www.mouser.tw/ProductDetail/Bourns/SRP1038C-8R2M?qs=PzGy0jfpSMuYIeNg8mWDuw%3D%3D) | 6 | CRCW06032K61FKEA | 10 | 0.581 | 5.81 |  | CRCW060336K5FKEAC | 10 | 0.547 | 5.47
CRCW060368K0FKEAHP (https://www.mouser.tw/ProductDetail/Vishay-Dale/CRCW060368K0FKEAHP?qs=VtqDKwJMr4Gb0wnFjhLAjw%3D%3D) | 4 | CRCW06033K30FKEA (https://www.mouser.tw/ProductDetail/Vishay-Dale/CRCW06033K30FKEA?qs=1ghF3ZI8kS8fRqapjAj84Q%3D%3D) | 10 | 0.581 | 5.81 |  | CRCW060390K9FKEA | 10 | 0.547 | 5.47
CRCW060353K6FKEAC (https://www.mouser.tw/ProductDetail/Vishay-Dale/CRCW060353K6FKEAC?qs=E3Y5ESvWgWM6XtlnV%2FboUA%3D%3D) | 6 | CRCW0603442KFKEA | 10 | 0.581 | 5.81 |  | CRCW060310K0FKEAC | 89 | 0.41 | 36.49
CRCW060310K2FKEAC (https://www.mouser.tw/ProductDetail/Vishay-Dale/CRCW060310K2FKEAC?qs=E3Y5ESvWgWO2d%2FK1Xnl55g%3D%3D) | 4 | CRCW060352K3FKEA | 10 | 0.581 | 5.81 |  | C0603C104M5RACTU (https://www.mouser.tw/ProductDetail/KEMET/C0603C104M5RACTU?qs=YkRtRX%252BfoqJT%252B0m410IP4A%3D%3D) | 112 | 0.342 | 38.304
CRCW0603243KFKEA (https://www.mouser.tw/ProductDetail/Vishay-Dale/CRCW0603243KFKEA?qs=r4nDQARJoM%2FD7T838fHglg%3D%3D) | 6 | CRCW060353K6FKEA (https://www.mouser.tw/ProductDetail/Vishay-Dale/CRCW060353K6FKEA?qs=t%2Fk8jExiEqtUVENO6f39Cw%3D%3D) | 10 | 0.581 | 5.81 |  | CRCW06037K87FKEA | 61 | 0.342 | 20.862
CRCW060316K9FKEA (https://www.mouser.tw/ProductDetail/Vishay-Dale/CRCW060316K9FKEA?qs=nXAB27Nveh7hEpGWO4phPA%3D%3D) | 4 | CRCW060354K9FKEA (https://www.mouser.tw/ProductDetail/Vishay-Dale/CRCW060354K9FKEA?qs=b7E%2F5v%252Bp8lqNIpTCMX%252BLUg%3D%3D) | 10 | 0.581 | 5.81 |  | CRCW06031K00FKEC | 61 | 0.274 | 16.714
CRCW0603442KFKEA (https://www.mouser.tw/ProductDetail/Vishay-Dale/CRCW0603442KFKEA?qs=kcr0bk%252BxakA1D%2Fy%2F79r44g%3D%3D) | 6 | CRCW06039K53FKEA (https://www.mouser.tw/ProductDetail/Vishay-Dale/CRCW06039K53FKEA?qs=NvrC5vRk3q5mn1EuZvzW6A%3D%3D) | 10 | 0.581 | 5.81
CRCW060390K9FKEA (https://www.mouser.tw/ProductDetail/Vishay-Dale/CRCW060390K9FKEA?qs=p%252BLVWBR7IxE76yiycPP2Mw%3D%3D) | 6 | CRCW060336K5FKEAC | 10 | 0.547 | 5.47
CRCW060312K1FKEAC (https://www.mouser.tw/ProductDetail/Vishay-Dale/CRCW060312K1FKEAC?qs=E3Y5ESvWgWN9Y92hj7wyUQ%3D%3D) | 6 | CRCW060390K9FKEAC (https://www.mouser.tw/ProductDetail/Vishay-Dale/CRCW060390K9FKEAC?qs=E3Y5ESvWgWMgs%2F7qdpUi%252Bw%3D%3D) | 10 | 0.547 | 5.47
CRCW060336K5FKEAC (https://www.mouser.tw/ProductDetail/Vishay-Dale/CRCW060336K5FKEAC?qs=E3Y5ESvWgWMdEpUIGWv3vQ%3D%3D) | 4
CRCW060311K8FKEA (https://www.mouser.tw/ProductDetail/Vishay-Dale/CRCW060311K8FKEA?qs=fJz2RDGtR40GZizpKEmzdw%3D%3D) | 4
CRCW060310K0FKEAHP (https://www.mouser.tw/ProductDetail/Vishay-Dale/CRCW060310K0FKEAHP?qs=FlFvgi4rxBwhwmNEaK0SzQ%3D%3D) | 4
CRCW060354K9FKEA (https://www.mouser.tw/ProductDetail/Vishay-Dale/CRCW060354K9FKEA?qs=b7E%2F5v%252Bp8lqNIpTCMX%252BLUg%3D%3D) | 4
CRCW06032K43FKEA (https://www.mouser.tw/ProductDetail/Vishay-Dale/CRCW06032K43FKEA?qs=eDxIiLd4fLRD3G8bVTELcA%3D%3D) | 4
CRCW060352K3FKEA (https://www.mouser.tw/ProductDetail/Vishay-Dale/CRCW060352K3FKEA?qs=SnLvHVux46osufKy5hEuZA%3D%3D) | 4
CRCW060373K2FKEA (https://www.mouser.tw/ProductDetail/Vishay-Dale/CRCW060373K2FKEA?qs=wtKLRx7HFiWbNo88VwpoiQ%3D%3D) | 4
TAS5825MRHBR (https://www.mouser.tw/ProductDetail/Texas-Instruments/TAS5825MRHBR?qs=f9yNj16SXrKGX4MqJgnnYg%3D%3D) | 4
L78M05CDT-TR (https://www.mouser.tw/ProductDetail/STMicroelectronics/L78M05CDT-TR?qs=JIXmGdi%252BcuKa7ml6d%2FqNIw%3D%3D) | 4
LM5001MAX-NOPB (https://www.mouser.tw/ProductDetail/Texas-Instruments/LM5001MAX-NOPB?qs=QbsRYf82W3FL7Egz0HJkAQ%3D%3D) | 4
TPS54560BDDA (https://www.mouser.tw/ProductDetail/Texas-Instruments/TPS54560BDDA?qs=gZXFycFWdAMqSdZZ7nACGQ%3D%3D) | 6
