aokblast/ThunderChargeXPro/RC_Charger_MainBoard/RC_Charger_MainBoard.kicad_pcb

## KiCad design RC_Charger_MainBoard/RC_Charger_MainBoard.kicad_pcb (2024-02-09)

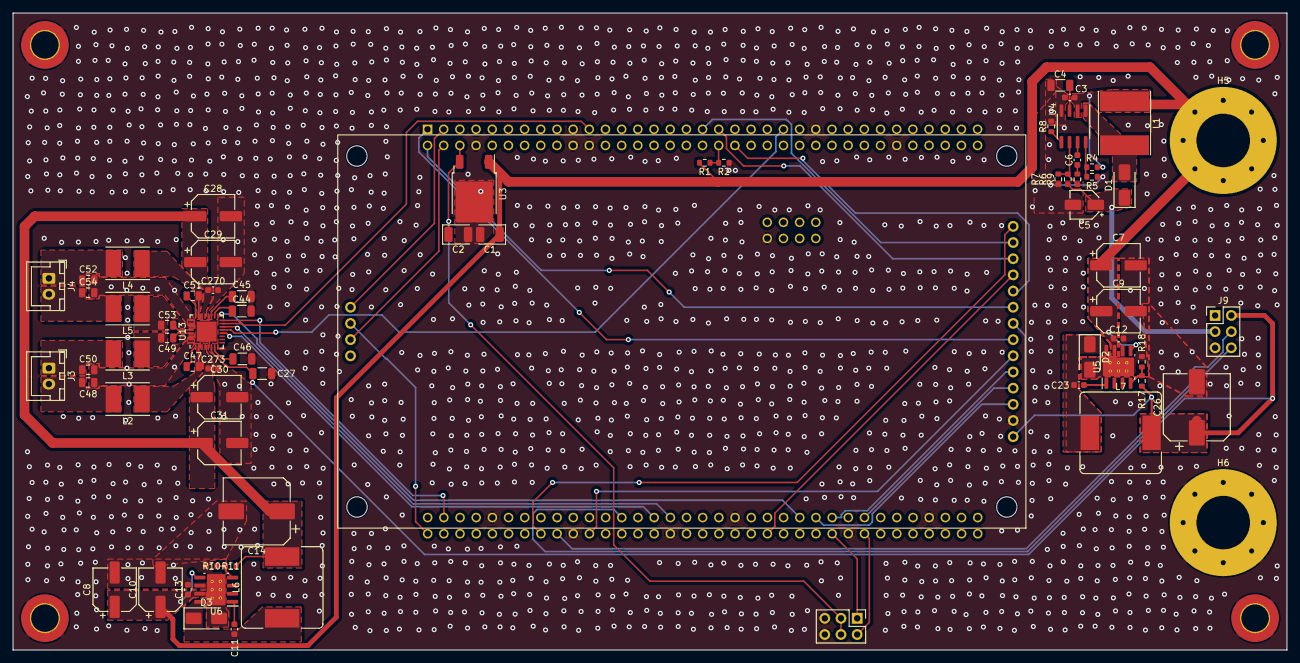
[picture p25: board RC_Charger_MainBoard.kicad_pcb from above]

Board: 2 copper layers, 200.0 x 100.0 mm, 73 parts (1 on the bottom side), 59 nets.

Parts:
C1, C2: 10u; CP_EIA-3528-21_Kemet-B
C3, C11, C12, C13, C23, C270, C273: 0.1u; C_0603_1608Metric
C4, C27, C44, C45, C46: 1u; C_1206_3216Metric
C5: 10u; CP_Elec_4x5.7
C6: 2.2n; C_0603_1608Metric
C7, C8, C9, C10: 68u; CP_Elec_6.3x7.7
C14, C26: 560u; CP_Elec_10x10
C28, C29, C30, C31: 22u; CP_Elec_6.3x5.4
C47, C49, C51, C53: 0.47u; C_0805_2012Metric
C48, C50, C52, C54: 0.68u; C_0805_2012Metric
D1: CDBA360-HF; D_SMA
D2, D3: SS54F; D_SMA
H1, H2, H3, H4: M4; MountingHole_4.3mm_M4_DIN965_Pad_TopBottom
H5, H6: M8; MountingHole_8.4mm_M8_Pad_Via
J1, J9: Conn_02x03_Odd_Even; PinHeader_2x03_P2.54mm_Vertical
J3: SPK1; JST_XH_B2B-XH-A_1x02_P2.50mm_Vertical
J4: SPK2; JST_XH_B2B-XH-A_1x02_P2.50mm_Vertical
L1: 100u; L_Taiyo-Yuden_NR-80xx_HandSoldering
L2, L3, L4, L5: 10u; L_Taiyo-Yuden_NR-50xx_HandSoldering
L6, L7: 15u; L_Bourns_SRR1260
R1: 68k; R_0603_1608Metric
R2, R10, R17: 10k; R_0603_1608Metric
R4: 53.6k; R_0603_1608Metric
R5: 12.1k; R_0603_1608Metric
R6: 54.9k; R_0603_1608Metric
R7: 2.43k; R_0603_1608Metric
R8: 52.3k; R_0603_1608Metric
R9: 73.2k; R_0603_1608Metric
R11: 3.24k; R_0603_1608Metric
R18: 5.9k; R_0603_1608Metric
U1: NUCLEO-H745ZI-Q; MODULE_NUCLEO-H745ZI-Q
U2: 4-inch SPI screen
U3: L7805; TO-252-2
U4: LM5001MA; SOIC-8_3.9x4.9mm_P1.27mm
U5, U6: TPS5430DDA; Texas_R-PDSO-G8_EP2.95x4.9mm_Mask2.4x3.1mm_ThermalVias
U13: TAS5825MRHB; VQFN-32-1EP_5x5mm_P0.5mm_EP3.1x3.1mm

Connections:
+5V: C2.1, J1.3, J1.4, U1.CN11_6 (5V_EXT), U3.3 (OUT)
/3V3 Buck/FB: R17.1, R18.2, U5.4 (VSENSE)
/5V Buck/FB: R10.1, R11.2, U6.4 (VSENSE)
/5V Buck/VOUT: C14.1, C28.1, C29.1, C30.1, C31.1, C270.1, C273.1, L6.2, R10.2, U13.3 (PVDD), U13.4 (PVDD), U13.21 (PVDD), U13.22 (PVDD)
GND: C1.2, C2.2, C3.2, C4.2, C5.2, C7.2, C8.2, C9.2, C10.2, C12.2, C13.2, C14.2, C26.2, C27.2, C28.2, C29.2, C30.2, C31.2, C44.2, C45.2, C46.2, C48.2, C50.2, C52.2, C54.2, C270.2, C273.2, D2.2 (A), D3.2 (A), H1.1, H2.1, H3.1, H4.1, H6.1, J1.5, J1.6, J9.5, R2.2, R5.1, R7.1, R8.1, R11.1, R18.1, U1.CN6_7 (GND_CN6), U1.CN11_8 (GND), U1.CN11_19 (GND), U1.CN11_20 (GND), U1.CN11_22 (GND), U1.CN11_49 (GND), U1.CN11_60 (GND), U1.CN12_9 (GND), U1.CN12_20 (GND), U1.CN12_32 (AGND), U1.CN12_39 (GND), U1.CN12_54 (GND), U1.CN12_63 (GND), U2.2 (GND), U3.2 (GND), U4.4 (GND), U5.6 (GND), U5.9 (GNDPAD), U6.6 (GND), U6.9 (GNDPAD), U13.5 (DGND), U13.8 (ADR), U13.20 (AGND), U13.25 (PGND), U13.26 (PGND), U13.31 (PGND), U13.32 (PGND), U13.33 (EP)
I2S_CLK: U1.CN12_31 (PB3), U13.14 (SDIN)
I2S_LRCLK: U1.CN12_29 (PB5/PA4), U13.12 (LRCLK)
I2S_MUTE: U1.CN12_47 (PE10), U13.17 (~PDN)
I2S_SCL: U1.CN12_3 (PB8), U13.16 (SCL)
I2S_SDA: U1.CN11_21 (PB7), U13.15 (SDA)
I2S_SDO: U1.CN11_45 (PD7), U13.13 (SCLK)
IO_SCL: J9.6, U1.CN12_25 (PB10)
IO_SDA: J9.4, U1.CN12_18 (PB11)
unnamed: C6.2, R9.2
unnamed: D1.2 (A), L1.2, U4.1 (SW)
unnamed: C23.2, D2.1 (K), L7.1, U5.8 (PH)
unnamed: C11.2, D3.1 (K), L6.1, U6.8 (PH)
unnamed: C50.1, J3.1, L3.2
unnamed: C48.1, J3.2, L2.2
unnamed: C52.1, J4.1, L4.2
unnamed: C54.1, J4.2, L5.2
unnamed: C6.1, U4.7 (COMP)
unnamed: R4.1, R5.2, U4.8 (EN)
unnamed: R6.1, R7.2, R9.1, U4.6 (FB)
unnamed: R8.2, U4.5 (RT)
unnamed: C4.1, U4.3 (VCC)
unnamed: C23.1, U5.1 (BOOT)
unnamed: C11.1, U6.1 (BOOT)
unnamed: C45.1, U13.19 (AVDD)
unnamed: C47.1, U13.1 (BST_A+)
unnamed: C49.1, U13.29 (BST_A-)
unnamed: C51.1, U13.24 (BST_B+)
unnamed: C53.1, U13.28 (BST_B-)
unnamed: C44.1, U13.18 (GVDD)
unnamed: C47.2, L2.1, U13.2 (OUT_A+)
unnamed: C49.2, L3.1, U13.30 (OUT_A-)
unnamed: C51.2, L4.1, U13.23 (OUT_B+)
unnamed: C53.2, L5.1, U13.27 (OUT_B-)
unnamed: C46.1, U13.7 (VR_DIG)
SDMMC1_CK: U1.CN11_3 (PC12), U2.18 (SD_SCK)
SDMMC1_CMD: U1.CN11_4 (PD2), U2.16 (SD_MOSI)
SDMMC1_DO: U1.CN12_2 (PC8), U2.17 (SD_MISO)
SERVO1: J1.1, U1.CN12_52 (PE9)
SERVO2: J1.2, U1.CN12_56 (PE11)
SSPI_MISO: U1.CN11_2 (PC11), U2.9 (SDO(MISO))
SSPI_MOSI: U1.CN12_22 (PB2), U2.6 (SDI(MOSI))
SSPI_SCK: U1.CN11_1 (PC10), U2.7 (SCK)
S_CS: U1.CN12_49 (PE12), U2.3 (CS)
S_DCRS: U1.CN12_51 (PE14), U2.5 (DC/RS)
S_PWR: C26.1, C27.1, J9.2, L7.2, R17.2, U2.1 (VCC), U2.8 (LED), U13.6 (DVDD)
S_RST: U1.CN12_55 (PE13), U2.4 (RESET)
TSPI_MISO: U1.CN11_35 (PC2), U2.13 (T_DO)
TSPI_MOSI: U1.CN11_37 (PC3), U2.12 (T_DIN)
TSPI_SCK: U1.CN11_40 (PD3), U2.10 (T_CLK)
T_CS: U1.CN12_44 (PE7), U2.11 (T_CS)
T_IRQ: U1.CN12_16 (PB12), U2.14 (T_IRQ)
VCC: C5.1, D1.1 (K), J9.3, R6.2
VIN: C1.1, C3.1, C7.1, C8.1, C9.1, C10.1, C12.1, C13.1, H5.1, L1.1, R1.1, R4.2, U3.1 (IN), U4.2 (VIN), U5.5 (EN), U5.7 (VIN), U6.5 (EN), U6.7 (VIN)
VSENSE: R1.2, R2.1, U1.CN11_38 (PC0)
