aokblast/ThunderChargeXPro/RC_Charger/RC_Charger.kicad_pcb

## KiCad design RC_Charger/RC_Charger.kicad_pcb (2024-02-09)

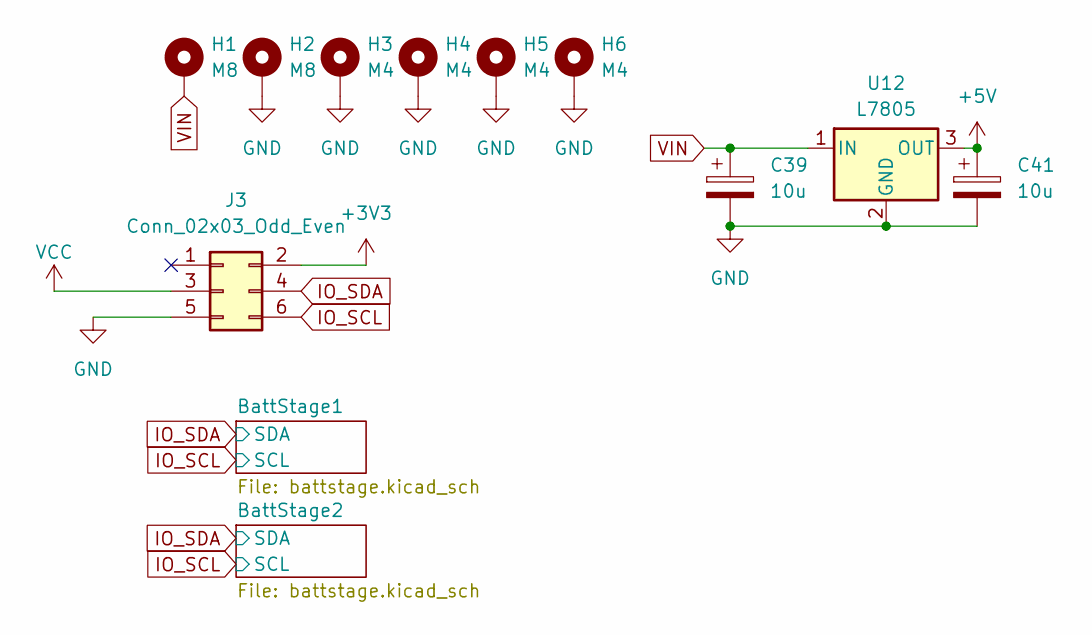
[picture p26: schematic RC_Charger.kicad_sch]

Parts:
C39, C41: 10u; CP_EIA-3528-21_Kemet-B
H1, H2: M8; MountingHole_8.4mm_M8_Pad_Via
H3, H4, H5, H6: M4; MountingHole_4.3mm_M4_DIN965_Pad_TopBottom
J3: Conn_02x03_Odd_Even; PinHeader_2x03_P2.54mm_Vertical
U12: L7805; TO-252-2

Connections:
+3V3: J3.2; also elsewhere on the board
+5V: C41.1, U12.3 (OUT); also elsewhere on the board
GND: C39.2, C41.2, H2.1, H3.1, H4.1, H5.1, H6.1, J3.5, U12.2 (GND); also elsewhere on the board
IO_SCL: J3.6; also elsewhere on the board
IO_SDA: J3.4; also elsewhere on the board
VCC: J3.3; also elsewhere on the board
VIN: C39.1, H1.1, U12.1 (IN); also elsewhere on the board

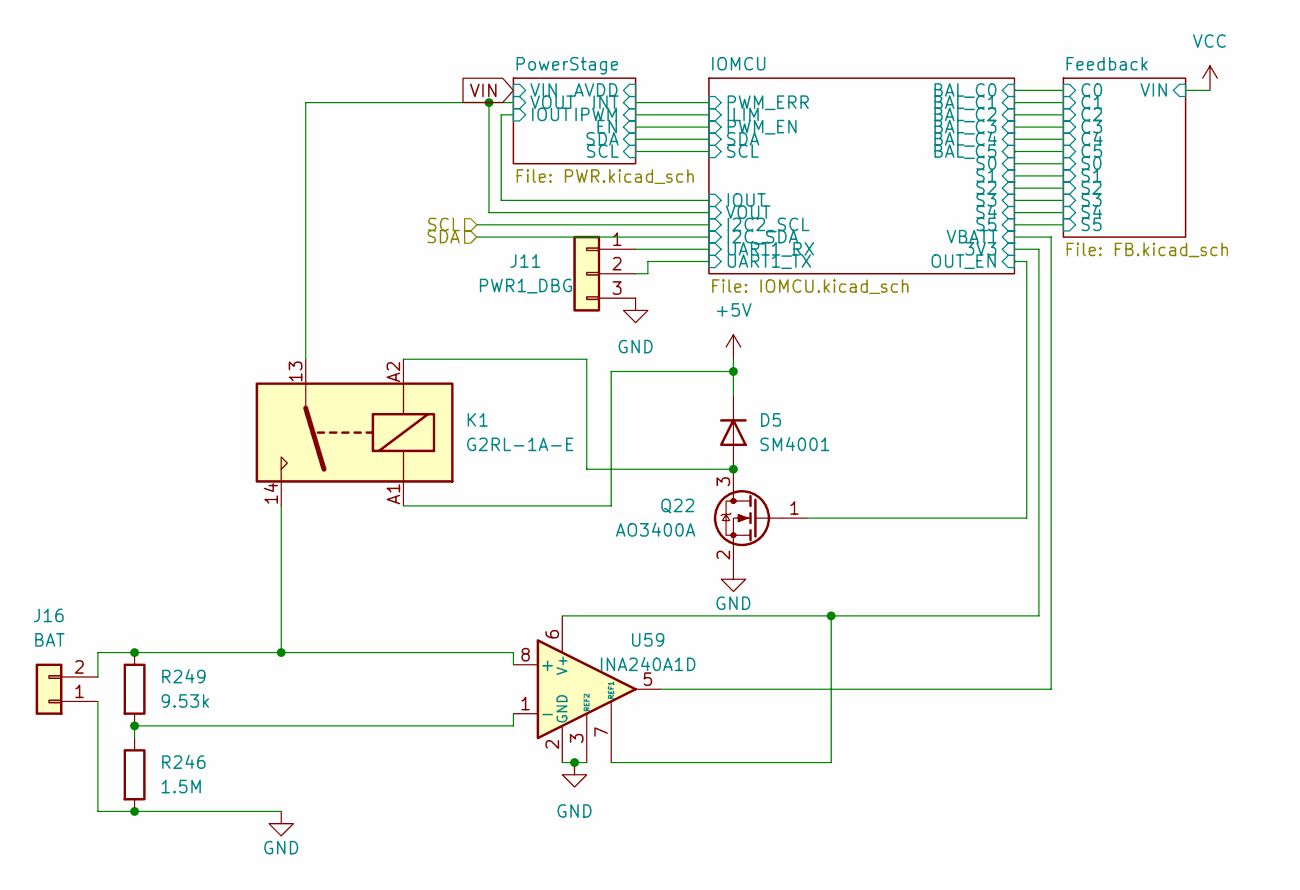
[picture p27: schematic battstage.kicad_sch]

Parts:
D5: SM4001; D_MELF
J11: PWR1_DBG; PinHeader_1x03_P2.54mm_Vertical
J16: BAT; TerminalBlock_Dinkle_DT-55-B01X-02_P10.00mm
K1: G2RL-1A-E; Relay_SPST_Omron_G2RL-1A-E
Q22: AO3400A; SOT-23
R246: 1.5M; R_0603_1608Metric
R249: 9.53k; R_0603_1608Metric
U59: INA240A1D; SOIC-8_3.9x4.9mm_P1.27mm

Connections:
+3V3: U59.6 (V+), U59.7 (REF1); also elsewhere on the board
+5V: D5.1 (K), K1.A1; also elsewhere on the board
/BattStage1/IOMCU/UART1_RX: J11.1; also elsewhere on the board
/BattStage1/IOMCU/UART1_TX: J11.2; also elsewhere on the board
/BattStage1/PowerStage/VOUT: K1.13; also elsewhere on the board
/BattStage2/IOMCU/OUT_EN: Q22.1 (G); also elsewhere on the board
/BattStage2/IOMCU/VBATT: U59.5; also elsewhere on the board
GND: J11.3, J16.1, Q22.2 (S), R246.2, U59.2 (GND), U59.3 (REF2), U59.4 (GND); also elsewhere on the board
unnamed: R246.1, R249.2, U59.1 (-)

Parts of its further copies:
D6: SM4001; D_MELF
J5: PWR1_DBG; PinHeader_1x03_P2.54mm_Vertical
J19: BAT; TerminalBlock_Dinkle_DT-55-B01X-02_P10.00mm
K2: G2RL-1A-E; Relay_SPST_Omron_G2RL-1A-E
Q21: AO3400A; SOT-23
R245: 1.5M; R_0603_1608Metric
R252: 9.53k; R_0603_1608Metric
U62: INA240A1D; SOIC-8_3.9x4.9mm_P1.27mm

Connections of its further copies:
+3V3: U62.6 (V+), U62.7 (REF1); also elsewhere on the board
+5V: D6.1 (K), K2.A1; also elsewhere on the board
/BattStage1/IOMCU/OUT_EN: Q21.1 (G); also elsewhere on the board
/BattStage1/IOMCU/VBATT: U62.5; also elsewhere on the board
/BattStage2/IOMCU/UART1_RX: J5.1; also elsewhere on the board
/BattStage2/IOMCU/UART1_TX: J5.2; also elsewhere on the board
/BattStage2/PowerStage/VOUT: K2.13; also elsewhere on the board
GND: J5.3, J19.1, Q21.2 (S), R245.2, U62.2 (GND), U62.3 (REF2), U62.4 (GND); also elsewhere on the board
unnamed: R245.1, R252.2, U62.1 (-)

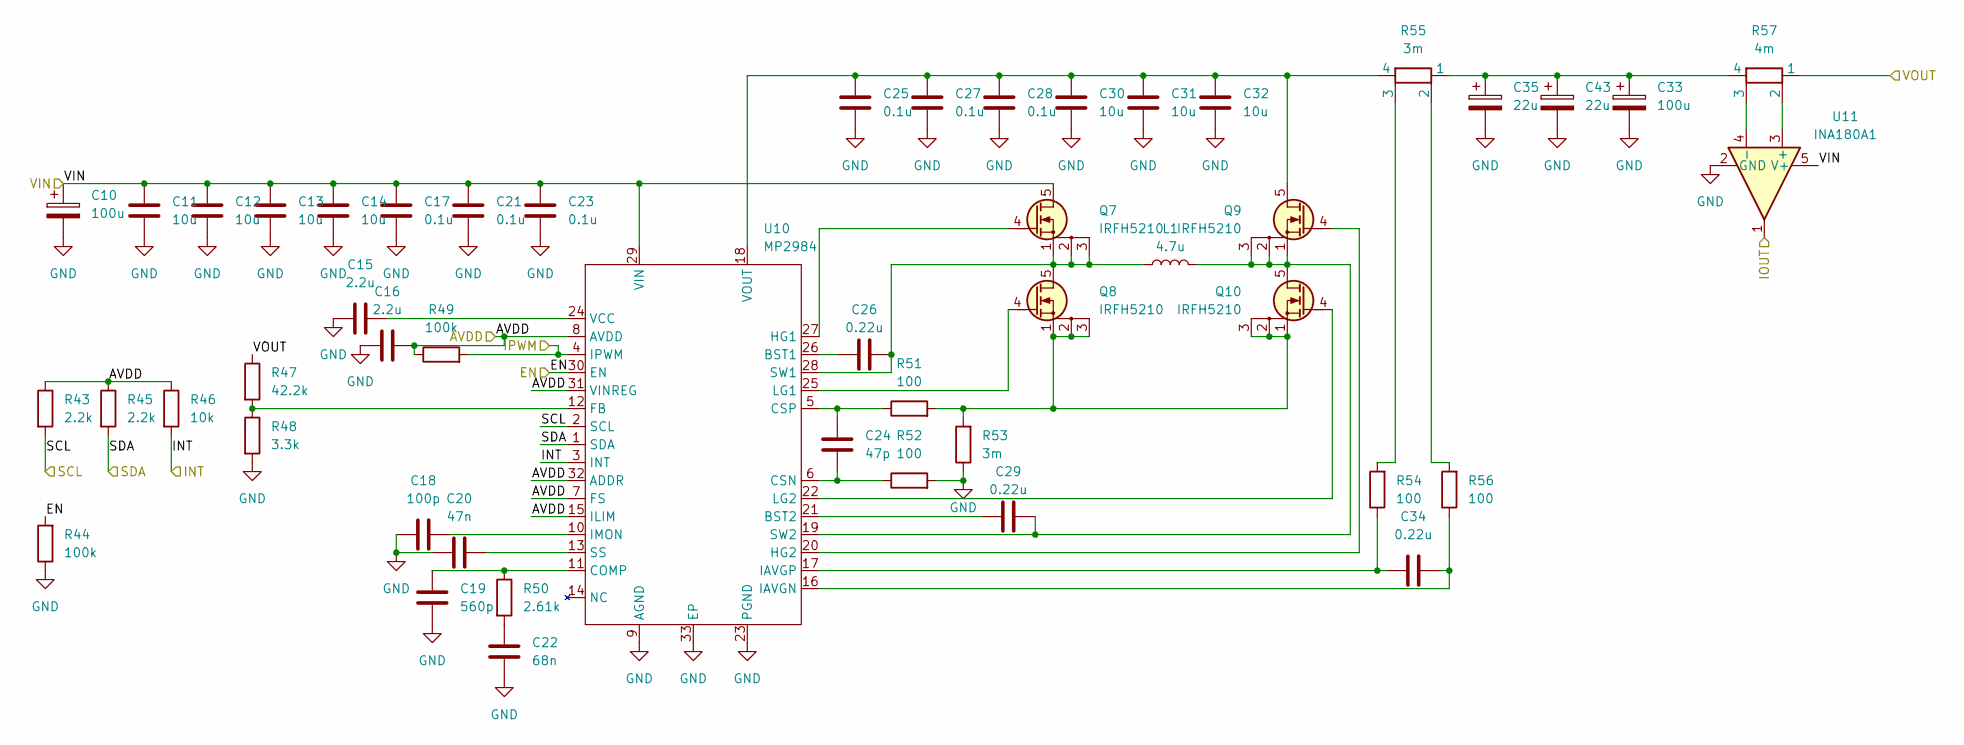
[picture p28: schematic PWR.kicad_sch]

Parts:
C10, C33: 100u; CP_Elec_6.3x7.7
C11, C12, C13, C14, C30, C31, C32: 10u; C_1206_3216Metric
C15, C16: 2.2u; C_0805_2012Metric
C17, C21, C23, C25, C27, C28: 0.1u; C_0603_1608Metric
C18: 100p; C_0603_1608Metric
C19: 560p; C_0603_1608Metric
C20: 47n; C_0603_1608Metric
C22: 68n; C_0603_1608Metric
C24: 47p; C_0603_1608Metric
C26, C29, C34: 0.22u; C_0603_1608Metric
C35, C43: 22u; CP_Elec_6.3x5.4
L1: 4.7u; L_Bourns_SRP1770TA_16.9x16.9mm
Q7, Q8, Q9, Q10: IRFH5210; PQFN-8-EP_6x5mm_P1.27mm_Generic
R43, R45: 2.2k; R_0603_1608Metric
R44, R49: 100k; R_0603_1608Metric
R46: 10k; R_0603_1608Metric
R47: 42.2k; R_0603_1608Metric
R48: 3.3k; R_0603_1608Metric
R50: 2.61k; R_0603_1608Metric
R51, R52, R54, R56: 100; R_0603_1608Metric
R53: 3m; R_Shunt_1575
R55: 3m; R_Shunt_Vishay_WSK2512_6332Metric_T2.21mm
R57: 4m; R_Shunt_Vishay_WSK2512_6332Metric_T2.21mm
U10: MP2984; QFN-32-1EP_4x4mm_P0.4mm_EP2.65x2.65mm
U11: INA180A1; SOT-23-5

Connections:
/BattStage1/IOMCU/ILIM: R49.2, U10.4 (IPWM); also elsewhere on the board
/BattStage1/IOMCU/IOUT: U11.1; also elsewhere on the board
/BattStage1/PowerStage/AVDD: C16.2, R43.1, R45.1, R46.1, R49.1, U10.7 (FS), U10.8 (AVDD), U10.15 (ILIM), U10.31 (VINREG), U10.32 (ADDR)
/BattStage1/PowerStage/EN: R44.2, U10.30 (EN); also elsewhere on the board
/BattStage1/PowerStage/INT: R46.2, U10.3 (INT); also elsewhere on the board
/BattStage1/PowerStage/SCL: R43.2, U10.2 (SCL); also elsewhere on the board
/BattStage1/PowerStage/SDA: R45.2, U10.1 (SDA); also elsewhere on the board
/BattStage1/PowerStage/VOUT: R47.1, R57.1; also elsewhere on the board
GND: C10.2, C11.2, C12.2, C13.2, C14.2, C15.1, C16.1, C17.2, C18.1, C19.2, C20.2, C21.2, C22.2, C23.2, C25.2, C27.2, C28.2, C30.2, C31.2, C32.2, C33.2, C35.2, C43.2, R44.1, R48.2, R52.2, R53.1, U10.9 (AGND), U10.23 (PGND), U10.33 (EP), U11.2 (GND); also elsewhere on the board
unnamed: C22.1, R50.2
unnamed: C33.1, C35.1, C43.1, R55.1, R57.4
unnamed: Q7.4 (G), U10.27 (HG1)
unnamed: C26.2, L1.1, Q7.1 (S), Q7.2 (S), Q7.3 (S), Q8.5 (D), U10.28 (SW1)
unnamed: Q8.4 (G), U10.25 (LG1)
unnamed: C25.1, C27.1, C28.1, C30.1, C31.1, C32.1, Q9.5 (D), R55.4, U10.18 (VOUT)
unnamed: Q9.4 (G), U10.20 (HG2)
unnamed: C29.2, L1.2, Q9.1 (S), Q9.2 (S), Q9.3 (S), Q10.5 (D), U10.19 (SW2)
unnamed: Q10.4 (G), U10.22 (LG2)
unnamed: Q8.1 (S), Q8.2 (S), Q8.3 (S), Q10.1 (S), Q10.2 (S), Q10.3 (S), R51.2, R53.2
unnamed: R54.2, R55.3
unnamed: R55.2, R56.2
unnamed: C26.1, U10.26 (BST1)
unnamed: C29.1, U10.21 (BST2)
unnamed: C19.1, R50.1, U10.11 (COMP)
unnamed: C24.2, R52.1, U10.6 (CSN)
unnamed: C24.1, R51.1, U10.5 (CSP)
unnamed: R47.2, R48.1, U10.12 (FB)
unnamed: C34.2, R56.1, U10.16 (IAVGN)
unnamed: C34.1, R54.1, U10.17 (IAVGP)
unnamed: C18.2, U10.10 (IMON)
unnamed: C20.1, U10.13 (SS)
unnamed: C15.2, U10.24 (VCC)
unnamed: R57.2, U11.3 (+)
unnamed: R57.3, U11.4 (-)
VIN: C10.1, C11.1, C12.1, C13.1, C14.1, C17.1, C21.1, C23.1, Q7.5 (D), U10.29 (VIN), U11.5 (V+); also elsewhere on the board

Parts of its further copies:
C36, C44: 22u; CP_Elec_6.3x5.4
C42, C55: 100u; CP_Elec_6.3x7.7
C56, C57, C58, C59, C75, C76, C77: 10u; C_1206_3216Metric
C60, C61: 2.2u; C_0805_2012Metric
C62, C66, C68, C70, C72, C73: 0.1u; C_0603_1608Metric
C63: 100p; C_0603_1608Metric
C64: 560p; C_0603_1608Metric
C65: 47n; C_0603_1608Metric
C67: 68n; C_0603_1608Metric
C69: 47p; C_0603_1608Metric
C71, C74, C79: 0.22u; C_0603_1608Metric
L6: 4.7u; L_Bourns_SRP1770TA_16.9x16.9mm
Q11, Q12, Q13, Q14: IRFH5210; PQFN-8-EP_6x5mm_P1.27mm_Generic
R62, R64: 2.2k; R_0603_1608Metric
R63, R68: 100k; R_0603_1608Metric
R65: 10k; R_0603_1608Metric
R66: 42.2k; R_0603_1608Metric
R67: 3.3k; R_0603_1608Metric
R69: 2.61k; R_0603_1608Metric
R70, R71, R73, R75: 100; R_0603_1608Metric
R72: 3m; R_Shunt_1575
R74: 3m; R_Shunt_Vishay_WSK2512_6332Metric_T2.21mm
R76: 4m; R_Shunt_Vishay_WSK2512_6332Metric_T2.21mm
U16: MP2984; QFN-32-1EP_4x4mm_P0.4mm_EP2.65x2.65mm
U17: INA180A1; SOT-23-5

Connections of its further copies:
/BattStage2/IOMCU/ILIM: R68.2, U16.4 (IPWM); also elsewhere on the board
/BattStage2/IOMCU/IOUT: U17.1; also elsewhere on the board
/BattStage2/PowerStage/AVDD: C61.2, R62.1, R64.1, R65.1, R68.1, U16.7 (FS), U16.8 (AVDD), U16.15 (ILIM), U16.31 (VINREG), U16.32 (ADDR)
/BattStage2/PowerStage/EN: R63.2, U16.30 (EN); also elsewhere on the board
/BattStage2/PowerStage/INT: R65.2, U16.3 (INT); also elsewhere on the board
/BattStage2/PowerStage/SCL: R62.2, U16.2 (SCL); also elsewhere on the board
/BattStage2/PowerStage/SDA: R64.2, U16.1 (SDA); also elsewhere on the board
/BattStage2/PowerStage/VOUT: R66.1, R76.1; also elsewhere on the board
GND: C36.2, C42.2, C44.2, C55.2, C56.2, C57.2, C58.2, C59.2, C60.1, C61.1, C62.2, C63.1, C64.2, C65.2, C66.2, C67.2, C68.2, C70.2, C72.2, C73.2, C75.2, C76.2, C77.2, R63.1, R67.2, R71.2, R72.1, U16.9 (AGND), U16.23 (PGND), U16.33 (EP), U17.2 (GND); also elsewhere on the board
unnamed: C36.1, C42.1, C44.1, R74.1, R76.4
unnamed: C67.1, R69.2
unnamed: Q11.4 (G), U16.27 (HG1)
unnamed: C71.2, L6.1, Q11.1 (S), Q11.2 (S), Q11.3 (S), Q12.5 (D), U16.28 (SW1)
unnamed: Q12.4 (G), U16.25 (LG1)
unnamed: Q12.1 (S), Q12.2 (S), Q12.3 (S), Q14.1 (S), Q14.2 (S), Q14.3 (S), R70.2, R72.2
unnamed: C70.1, C72.1, C73.1, C75.1, C76.1, C77.1, Q13.5 (D), R74.4, U16.18 (VOUT)
unnamed: Q13.4 (G), U16.20 (HG2)
unnamed: C74.2, L6.2, Q13.1 (S), Q13.2 (S), Q13.3 (S), Q14.5 (D), U16.19 (SW2)
unnamed: Q14.4 (G), U16.22 (LG2)
unnamed: R73.2, R74.3
unnamed: R74.2, R75.2
unnamed: C71.1, U16.26 (BST1)
unnamed: C74.1, U16.21 (BST2)
unnamed: C64.1, R69.1, U16.11 (COMP)
unnamed: C69.2, R71.1, U16.6 (CSN)
unnamed: C69.1, R70.1, U16.5 (CSP)
unnamed: R66.2, R67.1, U16.12 (FB)
unnamed: C79.2, R75.1, U16.16 (IAVGN)
unnamed: C79.1, R73.1, U16.17 (IAVGP)
unnamed: C63.2, U16.10 (IMON)
unnamed: C65.1, U16.13 (SS)
unnamed: C60.2, U16.24 (VCC)
unnamed: R76.2, U17.3 (+)
unnamed: R76.3, U17.4 (-)
VIN: C55.1, C56.1, C57.1, C58.1, C59.1, C62.1, C66.1, C68.1, Q11.5 (D), U16.29 (VIN), U17.5 (V+); also elsewhere on the board

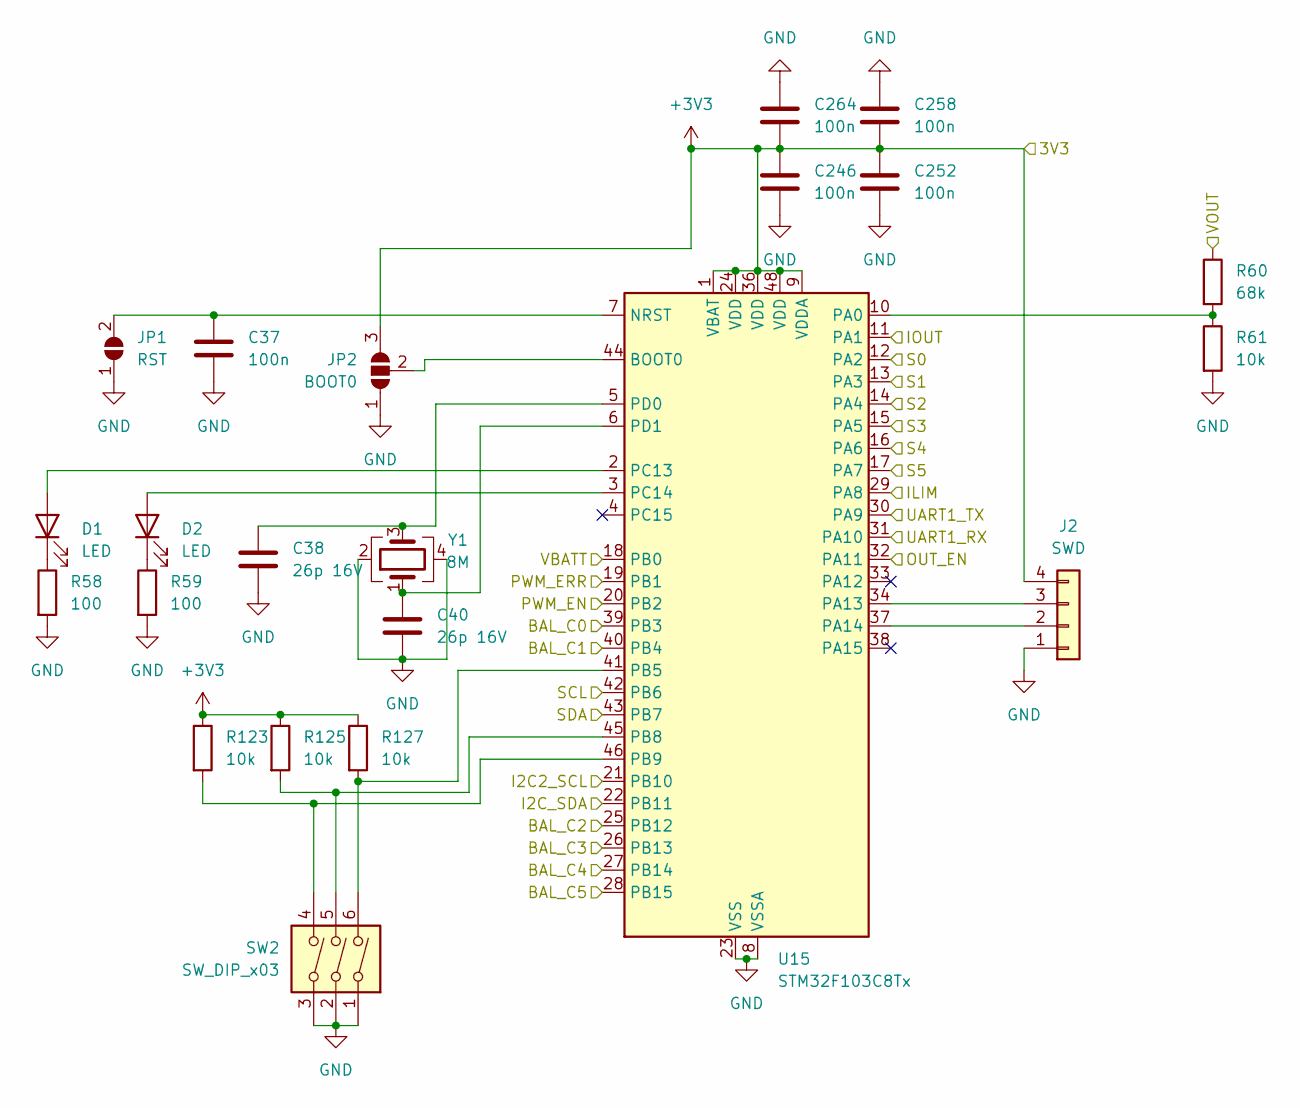
[picture p29: schematic IOMCU.kicad_sch]

Parts:
C37, C246, C252, C258, C264: 100n; C_0603_1608Metric
C38, C40: 26p 16V; C_0603_1608Metric
D1, D2: LED; LED_0603_1608Metric
J2: SWD; PinHeader_1x04_P2.54mm_Vertical
JP1: RST; SolderJumper-2_P1.3mm_Open_RoundedPad1.0x1.5mm
JP2: BOOT0; SolderJumper-3_P1.3mm_Open_Pad1.0x1.5mm
R58, R59: 100; R_0603_1608Metric
R60: 68k; R_0603_1608Metric
R61, R123, R125, R127: 10k; R_0603_1608Metric
SW2: SW_DIP_x03; SW_DIP_SPSTx03_Slide_9.78x9.8mm_W8.61mm_P2.54mm
U15: STM32F103C8Tx; LQFP-48_7x7mm_P0.5mm
Y1: 8M; Crystal_SMD_Abracon_ABM3B-4Pin_5.0x3.2mm

Connections:
+3V3: C246.1, C252.1, C258.2, C264.2, J2.4, JP2.3 (B), R123.1, R125.1, R127.1, U15.1 (VBAT), U15.9 (VDDA), U15.24 (VDD), U15.36 (VDD), U15.48 (VDD); also elsewhere on the board
/BattStage1/Feedback/C0: U15.39 (PB3); also elsewhere on the board
/BattStage1/Feedback/C1: U15.40 (PB4); also elsewhere on the board
/BattStage1/Feedback/C2: U15.25 (PB12); also elsewhere on the board
/BattStage1/Feedback/C3: U15.26 (PB13); also elsewhere on the board
/BattStage1/Feedback/C4: U15.27 (PB14); also elsewhere on the board
/BattStage1/Feedback/C5: U15.28 (PB15); also elsewhere on the board
/BattStage1/Feedback/S0: U15.12 (PA2); also elsewhere on the board
/BattStage1/Feedback/S1: U15.13 (PA3); also elsewhere on the board
/BattStage1/Feedback/S2: U15.14 (PA4); also elsewhere on the board
/BattStage1/Feedback/S3: U15.15 (PA5); also elsewhere on the board
/BattStage1/Feedback/S4: U15.16 (PA6); also elsewhere on the board
/BattStage1/Feedback/S5: U15.17 (PA7); also elsewhere on the board
/BattStage1/IOMCU/ILIM: U15.29 (PA8); also elsewhere on the board
/BattStage1/IOMCU/IOUT: U15.11 (PA1); also elsewhere on the board
/BattStage1/IOMCU/OUT_EN: U15.32 (PA11); also elsewhere on the board
/BattStage1/IOMCU/UART1_RX: U15.31 (PA10); also elsewhere on the board
/BattStage1/IOMCU/UART1_TX: U15.30 (PA9); also elsewhere on the board
/BattStage1/IOMCU/VBATT: U15.18 (PB0); also elsewhere on the board
/BattStage1/PowerStage/EN: U15.20 (PB2); also elsewhere on the board
/BattStage1/PowerStage/INT: U15.19 (PB1); also elsewhere on the board
/BattStage1/PowerStage/SCL: U15.42 (PB6); also elsewhere on the board
/BattStage1/PowerStage/SDA: U15.43 (PB7); also elsewhere on the board
/BattStage1/PowerStage/VOUT: R60.1; also elsewhere on the board
GND: C37.2, C38.1, C40.1, C246.2, C252.2, C258.1, C264.1, J2.1, JP1.1 (A), JP2.1 (A), R58.2, R59.2, R61.2, SW2.1, SW2.2, SW2.3, U15.8 (VSSA), U15.23 (VSS), U15.35 (VSS), U15.47 (VSS), Y1.2, Y1.4; also elsewhere on the board
IO_SCL: U15.21 (PB10); also elsewhere on the board
IO_SDA: U15.22 (PB11); also elsewhere on the board
unnamed: D1.2 (A), U15.2 (PC13)
unnamed: D1.1 (K), R58.1
unnamed: D2.2 (A), U15.3 (PC14)
unnamed: D2.1 (K), R59.1
unnamed: J2.2, U15.37 (PA14)
unnamed: J2.3, U15.34 (PA13)
unnamed: C37.1, JP1.2 (B), U15.7 (NRST)
unnamed: JP2.2 (C), U15.44 (BOOT0)
unnamed: R60.2, R61.1, U15.10 (PA0)
unnamed: C38.2, U15.5 (PD0), Y1.3
unnamed: C40.2, U15.6 (PD1), Y1.1

Parts of its further copies:
C91, C247, C253, C259, C265: 100n; C_0603_1608Metric
C92, C94: 26p 16V; C_0603_1608Metric
D3, D4: LED; LED_0603_1608Metric
J7: SWD; PinHeader_1x04_P2.54mm_Vertical
JP3: RST; SolderJumper-2_P1.3mm_Open_RoundedPad1.0x1.5mm
JP4: BOOT0; SolderJumper-3_P1.3mm_Open_Pad1.0x1.5mm
R119, R120: 100; R_0603_1608Metric
R121: 68k; R_0603_1608Metric
R122, R124, R126, R128: 10k; R_0603_1608Metric
SW1: SW_DIP_x03; SW_DIP_SPSTx03_Slide_9.78x9.8mm_W8.61mm_P2.54mm
U28: STM32F103C8Tx; LQFP-48_7x7mm_P0.5mm
Y2: 8M; Crystal_SMD_Abracon_ABM3B-4Pin_5.0x3.2mm

Connections of its further copies:
+3V3: C247.1, C253.1, C259.2, C265.2, J7.4, JP4.3 (B), R124.1, R126.1, R128.1, U28.1 (VBAT), U28.9 (VDDA), U28.24 (VDD), U28.36 (VDD), U28.48 (VDD); also elsewhere on the board
/BattStage2/Feedback/C0: U28.39 (PB3); also elsewhere on the board
/BattStage2/Feedback/C1: U28.40 (PB4); also elsewhere on the board
/BattStage2/Feedback/C2: U28.25 (PB12); also elsewhere on the board
/BattStage2/Feedback/C3: U28.26 (PB13); also elsewhere on the board
/BattStage2/Feedback/C4: U28.27 (PB14); also elsewhere on the board
/BattStage2/Feedback/C5: U28.28 (PB15); also elsewhere on the board
/BattStage2/Feedback/S0: U28.12 (PA2); also elsewhere on the board
/BattStage2/Feedback/S1: U28.13 (PA3); also elsewhere on the board
/BattStage2/Feedback/S2: U28.14 (PA4); also elsewhere on the board
/BattStage2/Feedback/S3: U28.15 (PA5); also elsewhere on the board
/BattStage2/Feedback/S4: U28.16 (PA6); also elsewhere on the board
/BattStage2/Feedback/S5: U28.17 (PA7); also elsewhere on the board
/BattStage2/IOMCU/ILIM: U28.29 (PA8); also elsewhere on the board
/BattStage2/IOMCU/IOUT: U28.11 (PA1); also elsewhere on the board
/BattStage2/IOMCU/OUT_EN: U28.32 (PA11); also elsewhere on the board
/BattStage2/IOMCU/UART1_RX: U28.31 (PA10); also elsewhere on the board
/BattStage2/IOMCU/UART1_TX: U28.30 (PA9); also elsewhere on the board
/BattStage2/IOMCU/VBATT: U28.18 (PB0); also elsewhere on the board
/BattStage2/PowerStage/EN: U28.20 (PB2); also elsewhere on the board
/BattStage2/PowerStage/INT: U28.19 (PB1); also elsewhere on the board
/BattStage2/PowerStage/SCL: U28.42 (PB6); also elsewhere on the board
/BattStage2/PowerStage/SDA: U28.43 (PB7); also elsewhere on the board
/BattStage2/PowerStage/VOUT: R121.1; also elsewhere on the board
GND: C91.2, C92.1, C94.1, C247.2, C253.2, C259.1, C265.1, J7.1, JP3.1 (A), JP4.1 (A), R119.2, R120.2, R122.2, SW1.1, SW1.2, SW1.3, U28.8 (VSSA), U28.23 (VSS), U28.35 (VSS), U28.47 (VSS), Y2.2, Y2.4; also elsewhere on the board
IO_SCL: U28.21 (PB10); also elsewhere on the board
IO_SDA: U28.22 (PB11); also elsewhere on the board
unnamed: D3.2 (A), U28.2 (PC13)
unnamed: D3.1 (K), R119.1
unnamed: D4.2 (A), U28.3 (PC14)
unnamed: D4.1 (K), R120.1
unnamed: J7.2, U28.37 (PA14)
unnamed: J7.3, U28.34 (PA13)
unnamed: C91.1, JP3.2 (B), U28.7 (NRST)
unnamed: JP4.2 (C), U28.44 (BOOT0)
unnamed: R121.2, R122.1, U28.10 (PA0)
unnamed: C92.2, U28.5 (PD0), Y2.3
unnamed: C94.2, U28.6 (PD1), Y2.1
