aokblast/ThunderChargeXPro/RC_Charger/RC_Charger.kicad_pcb

## KiCad design RC_Charger/RC_Charger.kicad_pcb (continued)

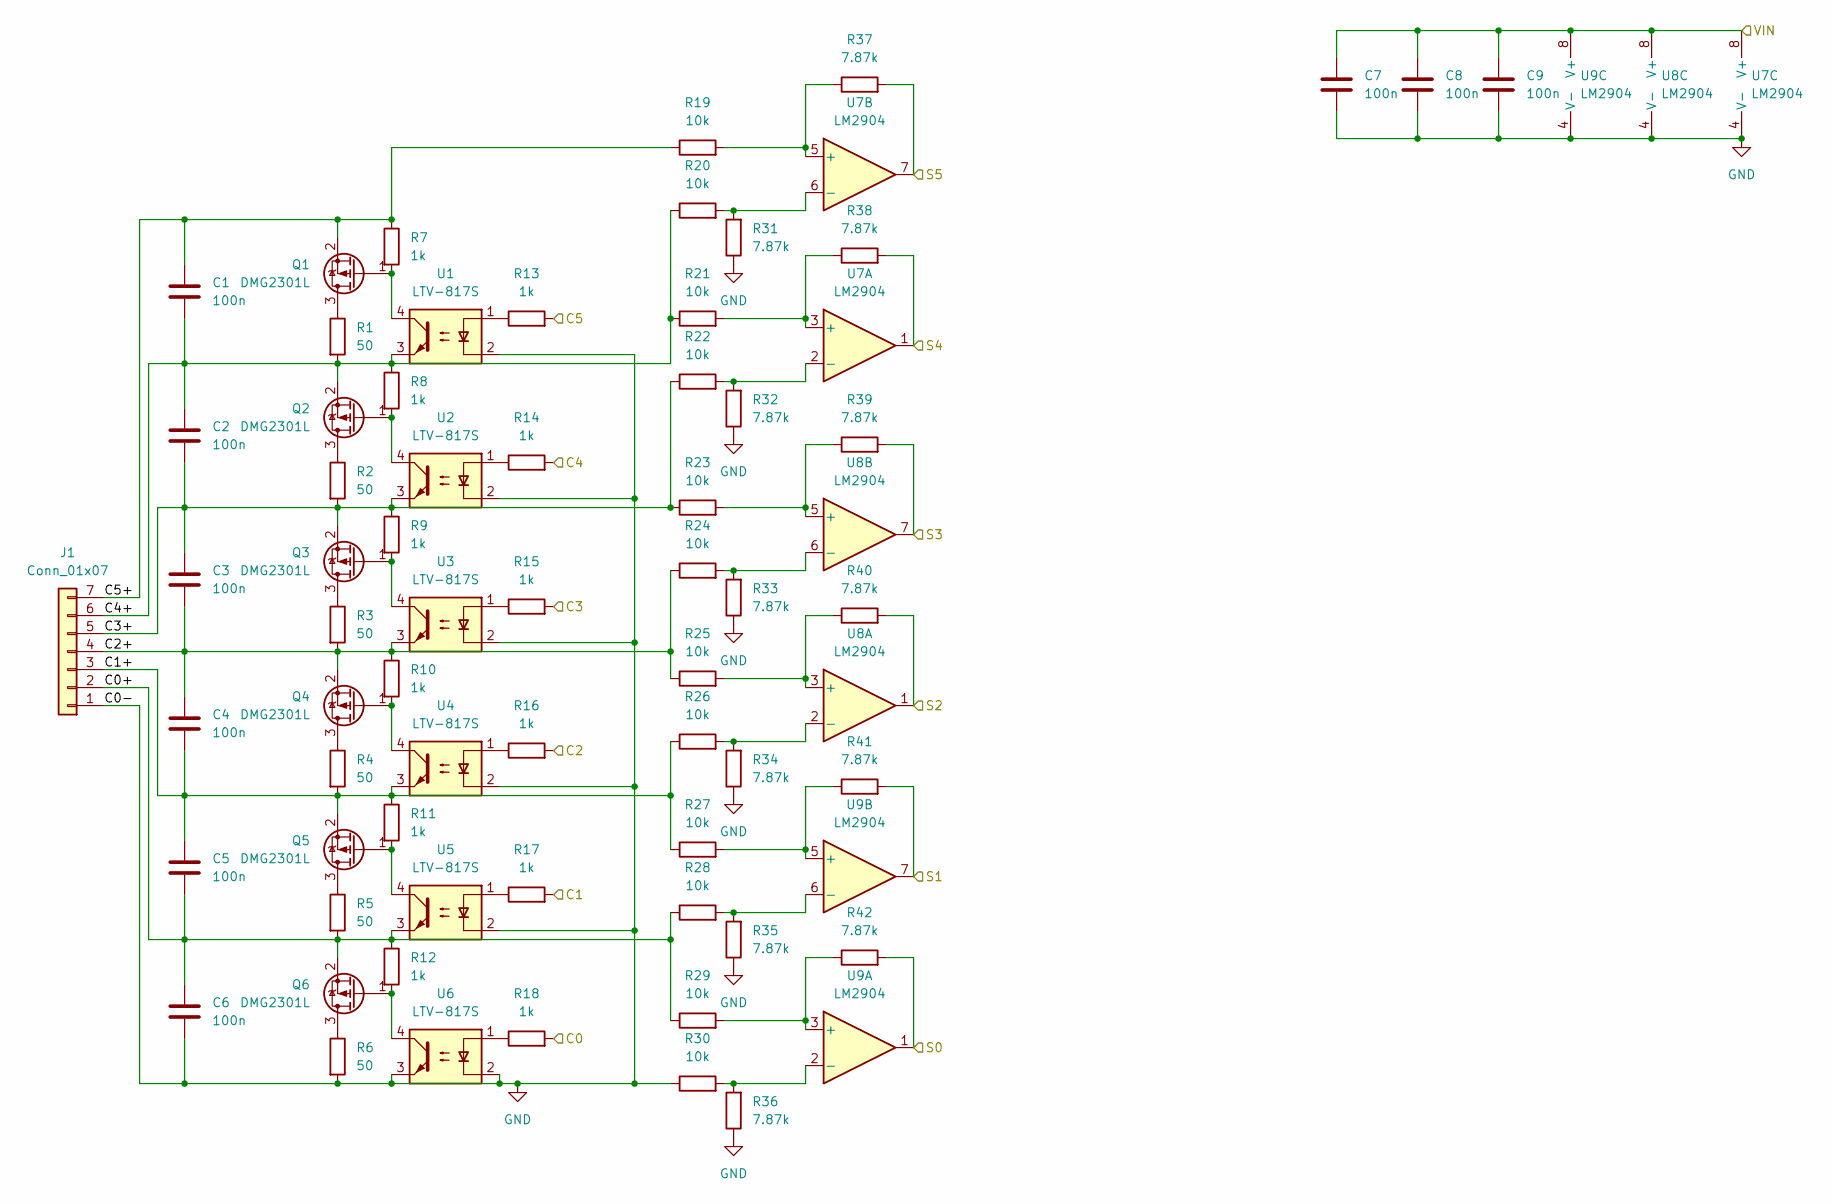
[picture p30: schematic FB.kicad_sch]

Parts:
C1, C2, C3, C4, C5, C6, C7, C8, C9: 100n; C_0603_1608Metric
J1: Conn_01x07; JST_XH_B7B-XH-A_1x07_P2.50mm_Vertical
Q1, Q2, Q3, Q4, Q5, Q6: DMG2301L; SOT-23
R1, R2, R3, R4, R5, R6: 50; R_2512_6332Metric
R7, R8, R9, R10, R11, R12, R13, R14, R15, R16, R17, R18: 1k; R_0603_1608Metric
R19, R20, R21, R22, R23, R24, R25, R26, R27, R28, R29, R30: 10k; R_0603_1608Metric
R31, R32, R33, R34, R35, R36, R37, R38, R39, R40, R41, R42: 7.87k; R_0603_1608Metric
U1, U2, U3, U4, U5, U6: LTV-817S; SMDIP-4_W9.53mm
U7, U8, U9: LM2904; SOIC-8_3.9x4.9mm_P1.27mm

Connections:
/BattStage1/Feedback/C0: R18.2; also elsewhere on the board
/BattStage1/Feedback/C0+: C5.2, C6.1, J1.2, Q6.2 (S), R5.2, R12.1, R28.1, R29.1, U5.3
/BattStage1/Feedback/C1: R17.2; also elsewhere on the board
/BattStage1/Feedback/C1+: C4.2, C5.1, J1.3, Q5.2 (S), R4.2, R11.1, R26.1, R27.1, U4.3
/BattStage1/Feedback/C2: R16.2; also elsewhere on the board
/BattStage1/Feedback/C2+: C3.2, C4.1, J1.4, Q4.2 (S), R3.2, R10.1, R24.1, R25.1, U3.3
/BattStage1/Feedback/C3: R15.2; also elsewhere on the board
/BattStage1/Feedback/C3+: C2.2, C3.1, J1.5, Q3.2 (S), R2.2, R9.1, R22.1, R23.1, U2.3
/BattStage1/Feedback/C4: R14.2; also elsewhere on the board
/BattStage1/Feedback/C4+: C1.2, C2.1, J1.6, Q2.2 (S), R1.2, R8.1, R20.1, R21.1, U1.3
/BattStage1/Feedback/C5: R13.2; also elsewhere on the board
/BattStage1/Feedback/C5+: C1.1, J1.7, Q1.2 (S), R7.1, R19.1
/BattStage1/Feedback/S0: R42.2, U9.1; also elsewhere on the board
/BattStage1/Feedback/S1: R41.2, U9.7; also elsewhere on the board
/BattStage1/Feedback/S2: R40.2, U8.1; also elsewhere on the board
/BattStage1/Feedback/S3: R39.2, U8.7; also elsewhere on the board
/BattStage1/Feedback/S4: R38.2, U7.1; also elsewhere on the board
/BattStage1/Feedback/S5: R37.2, U7.7; also elsewhere on the board
GND: C6.2, C7.2, C8.2, C9.2, J1.1, R6.2, R30.1, R31.1, R32.1, R33.1, R34.1, R35.1, R36.1, U1.2, U2.2, U3.2, U4.2, U5.2, U6.2, U6.3, U7.4 (V-), U8.4 (V-), U9.4 (V-); also elsewhere on the board
unnamed: Q1.3 (D), R1.1
unnamed: Q1.1 (G), R7.2, U1.4
unnamed: Q2.3 (D), R2.1
unnamed: Q2.1 (G), R8.2, U2.4
unnamed: Q3.3 (D), R3.1
unnamed: Q3.1 (G), R9.2, U3.4
unnamed: Q4.3 (D), R4.1
unnamed: Q4.1 (G), R10.2, U4.4
unnamed: Q5.3 (D), R5.1
unnamed: Q5.1 (G), R11.2, U5.4
unnamed: Q6.3 (D), R6.1
unnamed: Q6.1 (G), R12.2, U6.4
unnamed: R13.1, U1.1
unnamed: R14.1, U2.1
unnamed: R15.1, U3.1
unnamed: R16.1, U4.1
unnamed: R17.1, U5.1
unnamed: R18.1, U6.1
unnamed: R21.2, R38.1, U7.3 (+)
unnamed: R22.2, R32.2, U7.2 (-)
unnamed: R19.2, R37.1, U7.5 (+)
unnamed: R20.2, R31.2, U7.6 (-)
unnamed: R25.2, R40.1, U8.3 (+)
unnamed: R26.2, R34.2, U8.2 (-)
unnamed: R23.2, R39.1, U8.5 (+)
unnamed: R24.2, R33.2, U8.6 (-)
unnamed: R29.2, R42.1, U9.3 (+)
unnamed: R30.2, R36.2, U9.2 (-)
unnamed: R27.2, R41.1, U9.5 (+)
unnamed: R28.2, R35.2, U9.6 (-)
VCC: C7.1, C8.1, C9.1, U7.8 (V+), U8.8 (V+), U9.8 (V+); also elsewhere on the board

Parts of its further copies:
C82, C83, C84, C85, C86, C87, C88, C89, C90: 100n; C_0603_1608Metric
J6: Conn_01x07; JST_XH_B7B-XH-A_1x07_P2.50mm_Vertical
Q15, Q16, Q17, Q18, Q19, Q20: DMG2301L; SOT-23
R77, R78, R79, R80, R81, R82: 50; R_2512_6332Metric
R83, R84, R85, R86, R87, R88, R89, R90, R91, R92, R93, R94: 1k; R_0603_1608Metric
R95, R96, R97, R98, R99, R100, R101, R102, R103, R104, R105, R106: 10k; R_0603_1608Metric
R107, R108, R109, R110, R111, R112, R113, R114, R115, R116, R117, R118: 7.87k; R_0603_1608Metric
U18, U19, U20, U21, U22, U23: LTV-817S; SMDIP-4_W9.53mm
U24, U25, U26: LM2904; SOIC-8_3.9x4.9mm_P1.27mm

Connections of its further copies:
/BattStage2/Feedback/C0: R94.2; also elsewhere on the board
/BattStage2/Feedback/C0+: C86.2, C87.1, J6.2, Q20.2 (S), R81.2, R88.1, R104.1, R105.1, U22.3
/BattStage2/Feedback/C1: R93.2; also elsewhere on the board
/BattStage2/Feedback/C1+: C85.2, C86.1, J6.3, Q19.2 (S), R80.2, R87.1, R102.1, R103.1, U21.3
/BattStage2/Feedback/C2: R92.2; also elsewhere on the board
/BattStage2/Feedback/C2+: C84.2, C85.1, J6.4, Q18.2 (S), R79.2, R86.1, R100.1, R101.1, U20.3
/BattStage2/Feedback/C3: R91.2; also elsewhere on the board
/BattStage2/Feedback/C3+: C83.2, C84.1, J6.5, Q17.2 (S), R78.2, R85.1, R98.1, R99.1, U19.3
/BattStage2/Feedback/C4: R90.2; also elsewhere on the board
/BattStage2/Feedback/C4+: C82.2, C83.1, J6.6, Q16.2 (S), R77.2, R84.1, R96.1, R97.1, U18.3
/BattStage2/Feedback/C5: R89.2; also elsewhere on the board
/BattStage2/Feedback/C5+: C82.1, J6.7, Q15.2 (S), R83.1, R95.1
/BattStage2/Feedback/S0: R118.2, U26.1; also elsewhere on the board
/BattStage2/Feedback/S1: R117.2, U26.7; also elsewhere on the board
/BattStage2/Feedback/S2: R116.2, U25.1; also elsewhere on the board
/BattStage2/Feedback/S3: R115.2, U25.7; also elsewhere on the board
/BattStage2/Feedback/S4: R114.2, U24.1; also elsewhere on the board
/BattStage2/Feedback/S5: R113.2, U24.7; also elsewhere on the board
GND: C87.2, C88.2, C89.2, C90.2, J6.1, R82.2, R106.1, R107.1, R108.1, R109.1, R110.1, R111.1, R112.1, U18.2, U19.2, U20.2, U21.2, U22.2, U23.2, U23.3, U24.4 (V-), U25.4 (V-), U26.4 (V-); also elsewhere on the board
unnamed: Q15.3 (D), R77.1
unnamed: Q15.1 (G), R83.2, U18.4
unnamed: Q16.3 (D), R78.1
unnamed: Q16.1 (G), R84.2, U19.4
unnamed: Q17.3 (D), R79.1
unnamed: Q17.1 (G), R85.2, U20.4
unnamed: Q18.3 (D), R80.1
unnamed: Q18.1 (G), R86.2, U21.4
unnamed: Q19.3 (D), R81.1
unnamed: Q19.1 (G), R87.2, U22.4
unnamed: Q20.3 (D), R82.1
unnamed: Q20.1 (G), R88.2, U23.4
unnamed: R89.1, U18.1
unnamed: R90.1, U19.1
unnamed: R91.1, U20.1
unnamed: R92.1, U21.1
unnamed: R93.1, U22.1
unnamed: R94.1, U23.1
unnamed: R97.2, R114.1, U24.3 (+)
unnamed: R98.2, R108.2, U24.2 (-)
unnamed: R95.2, R113.1, U24.5 (+)
unnamed: R96.2, R107.2, U24.6 (-)
unnamed: R101.2, R116.1, U25.3 (+)
unnamed: R102.2, R110.2, U25.2 (-)
unnamed: R99.2, R115.1, U25.5 (+)
unnamed: R100.2, R109.2, U25.6 (-)
unnamed: R105.2, R118.1, U26.3 (+)
unnamed: R106.2, R112.2, U26.2 (-)
unnamed: R103.2, R117.1, U26.5 (+)
unnamed: R104.2, R111.2, U26.6 (-)
VCC: C88.1, C89.1, C90.1, U24.8 (V+), U25.8 (V+), U26.8 (V+); also elsewhere on the board

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
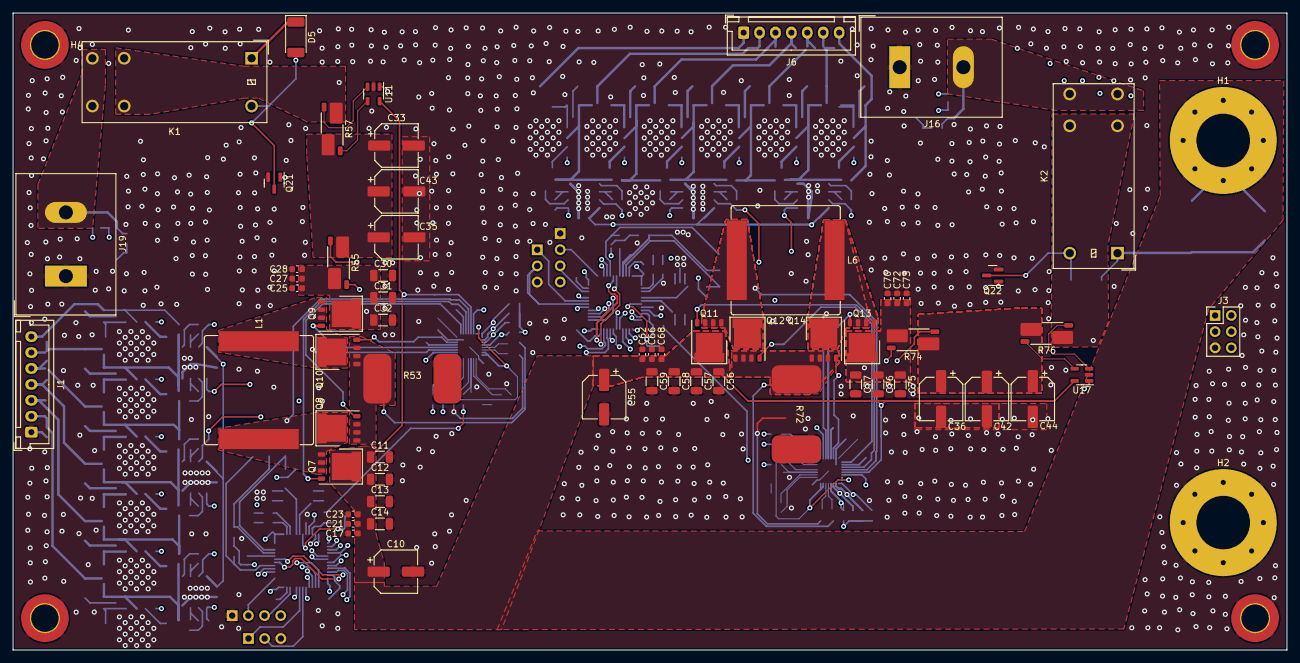
[picture p31: board RC_Charger.kicad_pcb from above]

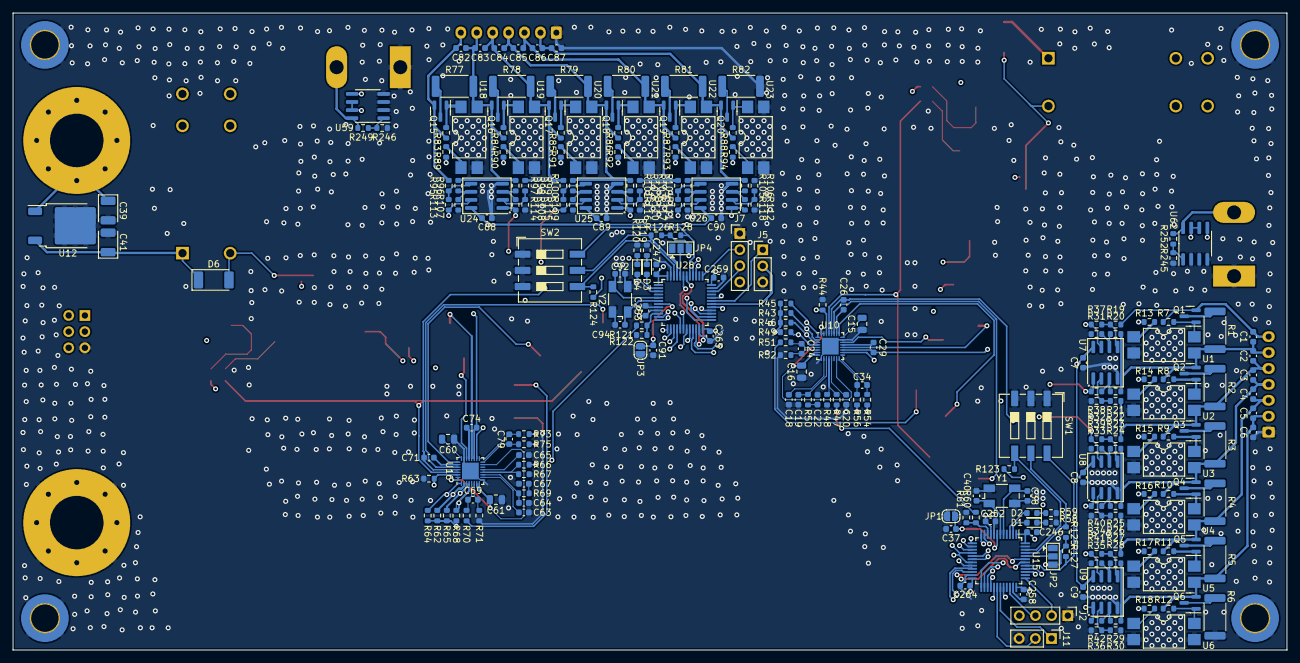
[picture p32: board RC_Charger.kicad_pcb from below]

Board: 4 copper layers, 200.0 x 100.0 mm, 302 parts (234 on the bottom side), 211 nets.
