aokblast/ThunderChargeXPro/Charger/Charger.ioc

Mcu.UserName=STM32H745ZITx
PA1.Signal=ETH_REF_CLK
PA11.Signal=USB_OTG_FS_DM
PA12.Signal=USB_OTG_FS_DP
PA2.Signal=ETH_MDIO
PA4.Signal=I2S1_WS
PA5.GPIO_Label=FAN_CTRL
PA5.Signal=GPIO_Output
PA7.Signal=ETH_CRS_DV
PA8.Signal=USB_OTG_FS_SOF
PA9.Signal=USB_OTG_FS_VBUS
PB0.GPIO_Label=LD1 [Green Led]
PB0.Signal=GPIO_Output
PB10.Signal=I2C2_SCL
PB11.Signal=I2C2_SDA
PB12.GPIO_Label=T_IRQ
PB12.Signal=GPXTI12
PB13.Signal=ETH_TXD1
PB14.GPIO_Label=LD3 [Red Led]
PB14.Signal=GPIO_Output
PB15.Signal=USART1_RX
PB2.Signal=SPI3_MOSI
PB6.Signal=USART1_TX
PB7.Signal=I2C1_SDA
PB8.Signal=I2C1_SCL
PC0.GPIO_Label=esnesV
PC0.Signal=ADCx_INP10
PC1.Signal=ETH_MDC
PC10.Signal=SPI3_SCK
PC11.Signal=SPI3_MISO
PC12.Signal=SDMMC1_CK
PC13.GPIO_Label=B1 [Blue PushButton]
PC13.Signal=GPIO_Input
PC2_C.Signal=SPI2_MISO
PC3_C.Signal=SPI2_MOSI
PC4.Signal=ETH_RXD0
PC5.Signal=ETH_RXD1
PC8.Signal=SDMMC1_D0
PD10.GPIO_Label=USB_OTG_FS_PWR_EN
PD10.Signal=GPIO_Output
PD2.Signal=SDMMC1_CMD
PD3.Signal=SPI2_SCK
PD7.Signal=I2S1_SDO
PD8.GPIO_Label=STLINK_RX
PD8.Signal=USART3_TX
PD9.GPIO_Label=STLINK_TX
PD9.Signal=USART3_RX
PE1.GPIO_Label=LD2 [Yellow Led]
PE1.Signal=GPIO_Output
PE10.GPIO_Label=Mute
PE10.Signal=GPIO_Output
PE11.GPIO_Label=SERVO2
PE11.Signal=S_TIM1_CH2
PE12.GPIO_Label=S_CS
PE12.Signal=GPIO_Output
PE13.GPIO_Label=S_RST
PE13.Signal=GPIO_Output
PE14.GPIO_Label=S_DCRS
PE14.Signal=GPIO_Output
PE7.GPIO_Label=T_CS
PE7.Signal=GPIO_Output
PE9.GPIO_Label=SERVO1
PE9.Signal=S_TIM1_CH1
PF11.GPIO_Label=esnesI
PF11.Signal=ADC1_INP2
PG11.Signal=ETH_TX_EN
PG13.Signal=ETH_TXD0
PG7.GPIO_Label=USB_OTG_FS_OVCR
PG7.Signal=GPXTI7
