aokblast/ThunderChargeXPro/(commit log)

2024-01-20 init pin define
2024-01-20 Change UART pin
2024-01-20 fix PA4 PB5 conflict
    [Charger.ioc]
2024-01-20 Add Mute Pin
2024-01-20 change 4*uart to i2c
2024-01-24 Add reverse voltage protection control
    [ChargerIO.ioc]
2024-01-27 change Vsense Pin
2024-01-28 Add Board Files
    [30Vboost.kicad_sch, Buck.kicad_sch, ClassD.kicad_pcb, ClassD.kicad_sch, FB.kicad_sch, IOMCU.kicad_sch, PWR.kicad_sch, RC_Charger.kicad_pcb]
2024-01-29 Change MainBoard Serov Position
    [RC_Charger_MainBoard.kicad_pcb]
2024-01-29 Change Charger Power Board Clearance Settings
    [RC_Charger.kicad_pcb, RC_Charger_MainBoard.kicad_pcb]
2024-02-06 Change components for costdown
    [30Vboost.kicad_sch, Buck.kicad_sch, ClassD.kicad_sch, RC_Charger_MainBoard.kicad_pcb, RC_Charger_MainBoard.kicad_sch, bom.csv, designators.csv, positions.csv]
2024-02-09 Add full bom and final pcb design
    [FullBOM.xlsx, IOMCU.kicad_sch, PWR.kicad_sch, RC_Charger.kicad_pcb, RC_Charger_MainBoard.kicad_pcb, battstage.kicad_sch, bom.csv, designators.csv]
2024-02-23 Add html bom
